darshacharya/KANDA/PUBLICATION_PLAN.md

# KANDA Paper Publication Plan

**Paper:** "KANDA: A Multimodal Embodied Robot Agent Driven by Large Language Models for Hardware-Conscious Command Generation"  
**Authors:** Sudarshan T S, Sushmitha N (RV College of Engineering, Bengaluru)  
**Date:** June 1, 2026

---

## Paper Summary

KANDA is a $77 multimodal embodied robot agent (ESP32 + Raspberry Pi 4 + camera) with voice, vision, text, and Telegram input. Uses Groq Llama 3.3 for text reasoning and NVIDIA NIM Llama 3.2 Vision for visual understanding. Features a deliberative-critic-reflex safety architecture based on Brooks' subsumption model. Key results: intent F1 = 0.94, visual search 80% success, all 8 injected faults terminate safely.

---

## Venue Options (Ranked by Budget)

### Tier 1: FREE ($0)

#### 1. Discover Robotics (Springer Nature) — TOP PICK
- **APC:** $0 / €0 / £0 (free until 31 Dec 2026)
- **Publisher:** Springer Nature
- **Indexing:** DOAJ; likely Scopus soon
- **Review:** Single-anonymous peer review
- **Type:** Journal (open access)
- **Turnaround:** ~29 weeks submission to publication
- **Link:** https://link.springer.com/journal/44430
- **Scope:** All fields of robotics — robot navigation, neurorobotics, bio-inspired learning, novel sensors
- **Why it fits:** LLM-driven embodied agent with hardware-aware action generation falls squarely in scope. Springer Nature imprint gives credibility. Newer journal (2024) so acceptance bar is more lenient.
- **Action:** Submit now. APC-free window closes 31 Dec 2026.

#### 2. arXiv Preprint (cs.RO)
- **Cost:** $0
- **Indexing:** Google Scholar, Semantic Scholar
- **Type:** Preprint (not peer-reviewed)
- **Turnaround:** 1-2 days
- **Why:** Citable DOI immediately, establish priority. Most venues allow dual arXiv + journal submission.

---

### Tier 2: VERY LOW COST (Under ₹5,000 / ~$60)

#### 3. AIRIM-2026 — AI, Robotics and Intelligent Manufacturing
- **Fee:** ₹4,000 + 18% GST (~₹4,720 / ~$56) for students with Scopus publication
- **Venue:** SRM University AP, Nov 5-7, 2026
- **Proceedings:** Springer "Lecture Notes in Networks and Systems" (Scopus-indexed)
- **Format:** Springer, up to 10 pages
- **Link:** https://www.srmap.edu.in/airim-2026/
- **Deadlines:** Paper submission revised Oct 2026; registration Aug-Oct 2026

#### 4. ICCMRAI-2026 — Computer, Mechatronics, Robotics & AI
- **Fee:** ₹4,000 (IEEE Student Member, early bird) / ₹5,000 (non-IEEE student)
- **Venue:** MMIT Pune, Jul 15-16, 2026
- **Proceedings:** IEEE Xplore (if presented)
- **Link:** https://mmit.edu.in/ieee-conference/
- **Note:** First edition — high acceptance likely. Check for late submission round.

#### 5. CIACON 2026 — IEEE Conference
- **Fee:** ₹5,000 (student, early bird before Jun 15)
- **Venue:** BC Roy Engineering College, India
- **Proceedings:** IEEE Xplore
- **Link:** https://ciacon.in/reg.html

---

### Tier 3: LOW COST (₹5,000–₹8,500 / ~$60–100)

#### 6. CSITSS 2026 — RVCE's Own Conference ⭐ HOME ADVANTAGE
- **Full Name:** International Conference on Computational Systems and Information Technology for Sustainable Solutions
- **Organizer:** RV College of Engineering, Bengaluru (home college)
- **Partner:** IEEE Bangalore Section
- **Dates:** Oct 30-31, 2026
- **Proceedings:** IEEE Xplore
- **Fee (IEEE student):** ₹5,310 (early bird, before Aug 30)
- **Fee (non-IEEE student):** ₹6,490 (early bird)
- **Link:** https://csitss.ieee-rvce.org/
- **Submission portal:** https://cmt3.research.microsoft.com/CSITSS2025
- **Key Dates:**
  - Submission opens: Apr 16, 2026
  - Last date to submit: **Jun 14, 2026**
  - Early bird registration deadline: Aug 30, 2026
  - Camera-ready + copyright: Sep 26, 2026
  - Conference: Oct 30-31, 2026
- **Best Track:** Track C — Advanced Robotics and Digital Technologies for Industrial Automation
- **Also fits:** Track A — Computing and Intelligent Systems
- **Relevant themes:** Soft Robotics, Generative & Agentic AI, Large Language Models and Generative AI, Cyber Physical System, AIoT
- **Why it fits:** Home advantage — guide Prof. Sushmitha N is from RVCE ISE dept which co-organizes. IEEE Xplore indexing. No travel cost. Higher acceptance rate for home institution. 6-page limit.
- **CSITSS trimmed version:** `kanda/overleaf/paper/kanda_csitss.tex` (435 lines, ~6 pages)

#### 7. IEEE ICRM 2026 — Robotics and Mechatronics
- **Fee:** ₹6,500 + GST (~₹7,670 / ~$91) for IEEE student author
- **Venue:** Amrita University, Kerala (virtual)
- **Proceedings:** IEEE Xplore
- **Link:** https://www.amrita.edu/events/icrm/

#### 8. COSMIC-2026 — Computing, Semiconductor, Mechatronics, Intelligent Systems
- **Fee:** TBD (~₹6,000-8,000 for students)
- **Venue:** Sahyadri College, Mangaluru, Nov 27-28, 2026
- **Proceedings:** IEEE Xplore + Scopus
- **Submission deadline:** Jul 10, 2026
- **Link:** https://cosmic.sahyadri.edu.in

---

### Tier 4: MODERATE COST (Journals with APC)

#### 9. HardwareX (Elsevier)
- **APC:** $500 (geo-pricing may reduce for India)
- **Indexing:** Scopus, DOAJ, ScienceDirect
- **Link:** https://www.sciencedirect.com/journal/hardwarex
- **Caveat:** Requires HardwareX template (hardware-focused). Need open hardware license. May need restructuring.

#### 10. MDPI Robotics
- **APC:** CHF 1,800 (~$2,000) — waivers available
- **Indexing:** Scopus, ESCI (Web of Science), dblp
- **Rank:** JCR Q2 (Robotics), CiteScore Q1
- **Turnaround:** ~24 days to first decision
- **Link:** https://www.mdpi.com/journal/robotics

#### 11. LITES — Leibniz Transactions on Embedded Systems
- **APC:** €100 (waivers for developing countries)
- **Indexing:** Open access
- **Link:** https://ojs.dagstuhl.de/index.php/lites/

#### 12. IEEE Access
- **APC:** $2,160 (20% discount for IEEE Society members)
- **Indexing:** Scopus, Web of Science
- **Link:** https://ieeeaccess.ieee.org/

---

## Recommended Strategy

1. **Immediate:** Submit to **arXiv (cs.RO)** — free, establishes priority, citable
2. **By Jun 14:** Submit trimmed 6-page version to **CSITSS 2026** (home conference, IEEE Xplore, ₹5,310)
3. **Parallel:** Submit full version to **Discover Robotics** (Springer, free APC until Dec 2026)
4. **Backup:** If CSITSS is rejected, target **AIRIM-2026** (Nov, Scopus Springer) or **COSMIC-2026** (Nov, IEEE Xplore)

The **Discover Robotics + arXiv** combo gives a Springer journal publication and immediate preprint for **zero cost**.

---

## CSITSS 2026 Trimming Summary

Created `kanda_csitss.tex` (435 lines) from original `kanda.tex` (570 lines).

### What was cut:
| Cut | Details |
|-----|---|
| Section 3 (Formal Problem Definition) | Folded Def 1 & 2 into "Three Tiers and Safety Definitions"; dropped Def 3-5 |
| Related Work | Compressed from 3 paragraphs to 1 |
| Section 7 (Discussion) | Removed; key insights moved to Conclusion |
| Listing 1 (body-context block) | Removed; described in prose |
| Wire Protocol subsection | Removed; single UART sentence in tier description |
| Figure 3 (state machine) | Removed; states described in text |
| Figures 1 & 2 | Shrunk from 6.2/5.5cm to 5.0cm |
| Evaluation prose | Trimmed verbose explanations |
| References | Cut from 20 to 16 |

### What's preserved:
- Full abstract with all quantitative results
- All 5 tables (voice, faults, ablation, timing, BOM)
- Algorithm 1 (episodic visual search)
- Validator code listing
- Robot photo and architecture figures
- All key contributions and ablation evidence

---

## Files

| File | Description |
|---|---|
| `kanda/overleaf/paper/kanda.tex` | Full paper (~9-10 pages, IEEE format) |
| `kanda/overleaf/paper/kanda_csitss.tex` | CSITSS trimmed version (~6 pages) |
| `kanda/overleaf/paper/kanda_text.txt` | Plain text version of full paper |
| `kanda/overleaf/paper/gouth.tex` | (Other paper file) |
