darshacharya/KANDA/overleaf/chapters/chapter2.tex

% ================================================================
%  Chapter 2 — Theory and Concepts
%  KANDA (Knowledge-driven Autonomous Navigation and Decision-making Agent)
% ================================================================
\chapter{THEORY AND CONCEPTS}
\label{ch:theory}

Building a robot that listens, sees, thinks, and moves requires pulling ideas from several fields at once. This chapter lays out those ideas, not as a textbook survey, but tied directly to decisions I had to make while constructing KANDA. Why does the language model need to know the robot's sensor readings? Why can I not just send raw text to the motors? Why does the ESP32 need its own safety logic when the Pi is already running a validator? Each section answers one of these questions by grounding it in published work and then connecting it to my specific implementation choices.

%-------------------------------------------------------------------
\section{Embodied Artificial Intelligence}
\label{sec:embodied}

A language model sitting on a server can write poetry about walking, but it has never tripped over a cable. \textbf{Embodied AI} closes that gap; it insists that intelligent behaviour only makes sense when perception and action happen through a real body interacting with a physical world. The distinction matters practically: an embodied system must deal with noise from cheap sensors, latency over wireless links, and the fact that motors do not care about elegant sentences.

These systems cost tens or hundreds of thousands of dollars. KANDA asks a simpler question: can the \textit{behaviours} that matter for a desk-sized indoor robot (obstacle avoidance, voice commands, object search) run on a \$77 platform with no training data at all? The answer turns out to be yes, but only if I respect the old principle from Brooks~\cite{brooks1986robust} that fast reactive layers must sit beneath slow deliberative ones. My firmware reflex traces its lineage directly to subsumption architecture, even though the deliberation layer above it uses a 70-billion parameter model hosted in the cloud.

These systems cost tens or hundreds of thousands of dollars. KANDA asks a simpler question: can the \textit{behaviours} that matter for a desk-sized indoor robot (obstacle avoidance, voice commands, object search) run on a \$77 platform with no training data at all? The answer turns out to be yes, but only if we respect the old principle from Brooks~\cite{brooks1986robust} that fast reactive layers must sit beneath slow deliberative ones. Our firmware reflex traces its lineage directly to subsumption architecture, even though the deliberation layer above it uses a 70-billion parameter model hosted in the cloud.

%-------------------------------------------------------------------
\subsection{Affordance Grounding}
\label{subsec:affordance}

Gibson coined the term \textit{affordance} to describe what an environment offers a particular agent; a chair affords sitting for a human but not for a fish. In robotics, the question becomes: given a language command like ``put the cup on the shelf,'' which physical actions can this robot actually perform?

SayCan~\cite{ahn2022saycan} tackled this by training affordance functions from 68,000 demonstrations. When a user issued a command, the system combined the language model's preference with a learned feasibility score to pick actions the robot could physically execute. PaLM-E~\cite{driess2023palme} took a different route, embedding sensor tokens directly into the language model so it could reason about feasibility internally. RT-2~\cite{brohan2023rt2} pushed further; it fine-tuned a vision-language model end-to-end so that the model output was itself a motor command, eliminating the separate affordance filter.

I could not afford 68,000 demonstrations, a 562B model, or end-to-end fine-tuning. Instead, KANDA encodes affordances directly in the prompt: seven legal actions, a speed range of 0--255, and live ultrasonic distances. The model cannot propose ``fly'' or ``speed 500'' because the prompt tells it those do not exist. This is crude compared to learned affordances, but it costs nothing to maintain and catches most hallucinated actions before validation even runs.

%-------------------------------------------------------------------
\section{Large Language Models for Robot Control}
\label{sec:llm_robot}

Transformers~\cite{vaswani2017attention} revolutionised natural language processing by replacing recurrence with self-attention, enabling parallel training on massive corpora. The resulting models (GPT-4, Llama, Gemini) generate fluent text, but fluency does not imply physical feasibility. A model might confidently suggest ``accelerate to 400'' when the motor driver caps at 255.

The gap between linguistic competence and physical grounding defines the core challenge. Vemprala et al.~\cite{vemprala2024chatgpt} articulated this in 2024: successful LLM-robot integration requires (a)~a clear description of the robot's capabilities in the prompt, (b)~low-temperature sampling to suppress creative but dangerous outputs, and (c)~a post-generation filter that catches anything the prompt did not prevent. KANDA implements all three, though I arrived at this design through trial and error before reading their systematic treatment.

%-------------------------------------------------------------------
\subsection{Prompting as Interface Specification}
\label{subsec:prompting}

Rather than training models on robot data, several groups discovered that careful prompting alone can produce usable control outputs. Huang et al.~\cite{huang2022zeroshot} first demonstrated that language models serve as effective zero-shot planners when carefully framed. Liang et al.~\cite{liang2023code} framed the prompt as a Python API specification and let the model write policy code. Singh et al.~\cite{singh2023progprompt} went further, declaring robot functions and world state in the prompt so the model could generate situated programs.

Chain-of-thought prompting~\cite{wei2022cot} showed that forcing the model to ``think step by step'' improves multi-step planning. Yao et al.\ combined this with action execution in ReAct~\cite{yao2023react}, where the model alternates between reasoning traces and concrete actions, observing results before deciding the next step. Our visual search algorithm borrows this structure: capture a frame, describe it, decide whether the target is visible, then pick the next movement.

KANDA's prompt is deliberately simpler than these systems. I do not generate code or multi-step reasoning chains at inference time. The prompt specifies seven verbs, a numeric speed field, and current sensor readings. The model returns a single JSON line. This keeps the firmware parser trivial and the validator unambiguous.

%-------------------------------------------------------------------
\subsection{Grounded Decoding and Post-Hoc Validation}
\label{subsec:grounded}

Huang et al.~\cite{huang2023grounded} proposed an elegant idea: during token generation, multiply the language model's probability distribution by a grounding signal (e.g., a feasibility score from a physics model) so that infeasible tokens get suppressed before they even appear in the output. This requires access to the model's logits, something cloud APIs generally do not expose.

KANDA takes the conceptually similar but architecturally distinct approach of post-hoc validation. I let the model generate freely, then run a total function $V$ that either accepts the output (if action $\in$ whitelist and speed $\in [0,255]$) or replaces it with a stop command. The validator never raises an exception, never passes garbage downstream, and adds negligible latency ($<$1\,ms). It is less elegant than logit-level intervention, but works with any API, any model, and any future provider swap.

%-------------------------------------------------------------------
\section{Sense-Reason-Act Architecture}
\label{sec:sra}

Most autonomous robots follow a loop: read sensors, compute a decision, execute it, repeat. KANDA splits this across two processors running at wildly different speeds, and that split drives much of the architecture.

The ESP32 reads three ultrasonic sensors every 100\,ms, fast enough to catch a hand waving in front of the robot. The Raspberry Pi calls Groq or NVIDIA NIM over the network, which takes 1.5--4 seconds depending on server load and prompt length. If I forced the ESP32 to wait for every cloud response, the robot would lurch forward blindly during those seconds. Instead, the firmware runs its own obstacle-avoidance rules whenever the Pi has not sent a command recently (timeout: 3 seconds). The Pi's commands override these rules when they arrive, but the firmware never stops watching the sensors.

This is not a novel idea; Brooks described it in 1986~\cite{brooks1986robust}. What is new is layering a cloud-hosted 70B-parameter model on top of a \$4 microcontroller and still preserving sub-100\,ms reflexes. The trick is accepting that the LLM is advisory, not authoritative. It suggests; the validator approves; the firmware obeys, or overrides if the wall is too close.

%-------------------------------------------------------------------
\section{Proximate Sensing with Ultrasonic Rangefinders}
\label{sec:ultrasonic}

HC-SR04 modules are cheap, widely available, and good enough for indoor obstacle detection within 2--400\,cm. The Dynamic Window Approach~\cite{fox1997dwa} provides a formal basis for velocity-space obstacle avoidance; our threshold-based design simplifies this to a binary stop decision at 15\,cm. The principle is straightforward: a 40\,kHz burst leaves the transmitter, bounces off a surface, and returns to the receiver. The module holds an echo pin high for the round-trip duration $\Delta t$, and distance follows from $d = \frac{1}{2} \cdot 343 \cdot \Delta t$ metres at room temperature.

In practice, three issues dominated our debugging time. First, the 15-degree beam width means small objects at oblique angles go undetected. Second, running three sensors simultaneously causes cross-talk where one sensor picks up another's echo. We solved this by triggering them sequentially within each loop iteration. Third, the HC-SR04 outputs 5V echo pulses, but ESP32 GPIO pins tolerate only 3.3V. Resistor dividers on each echo line handle the level shift; without them, the ESP32 reads noise or risks input damage.

%-------------------------------------------------------------------
\section{PWM Actuation and Motor Drive}
\label{sec:pwm}

DC motors spin faster with higher average voltage. Rather than regulating actual voltage, we switch full supply on and off rapidly (Pulse Width Modulation) so that the motor sees an effective average proportional to the duty cycle. The ESP32's LEDC peripheral~\cite{espressif2023esp32} generates PWM signals with 8-bit resolution (0--255) at 1\,kHz, which is high enough that the motors hum rather than click.

The TB6612FNG dual H-bridge sits between the ESP32 logic and the motors. Two direction pins per channel set forward or reverse; one PWM pin per channel sets speed. For differential steering, equal duty on both channels drives straight; unequal duty turns gently; reversing one channel spins in place. KANDA maps abstract LLM verbs (\textit{forward}, \textit{slight\_left}, \textit{right}) to specific combinations of direction bits and PWM values in firmware, so the language model never deals with pin-level hardware.

%-------------------------------------------------------------------
\section{Inter-Processor Communication over UART}
\label{sec:uart}

UART serial at 115,200 baud connects the Raspberry Pi and ESP32 with just two wires (TX and RX, plus ground). No clock line, no protocol negotiation; bytes flow at the agreed rate with start and stop framing. I chose newline-terminated JSON as the message format for a practical reason: it is human-readable in a serial monitor, which saved hours during early integration when half the bugs were bad baud rates or swapped TX/RX wires.

The Pi sends one JSON object per line: \textit{\{"action":"forward","speed":120\}}. The ESP32 replies with sensor telemetry in a fixed ASCII format: \textit{F:30.5 L:21.0 R:16.4 -> FORWARD}. Both sides use newline as the message delimiter. ArduinoJson parses the inbound line on the ESP32; Python's \textit{json.loads} handles it on the Pi. The simplicity of this protocol (no handshake, no sequence numbers, no retransmission) means occasional dropped bytes produce a parse failure that the validator catches and maps to stop. Reliability through simplicity.

%-------------------------------------------------------------------
\section{Safety Validation for LLM-Generated Actions}
\label{sec:safety_theory}

Language models hallucinate. They invent actions that do not exist, propose speeds that exceed hardware limits, wrap JSON in markdown fences, or occasionally return poetry instead of motor commands. KANDA assumes every LLM output is adversarial until proven otherwise.

The validator implements four checks in sequence: (1)~is the output a dictionary with the right keys? (2)~is the action one of seven known verbs? (3)~can the speed field be parsed as an integer? (4)~is that integer within $[0,255]$? Failure at any stage produces a safe stop command. Speed values outside the range but otherwise valid get clamped rather than rejected, so ``speed 300'' becomes ``speed 255'' rather than a full stop. This design treats the validator as a total function: it always terminates, always returns a legal command, and never throws~\cite{huang2023grounded,ahn2022saycan}.

The firmware adds a second, independent safety layer. Even if the Pi's validator somehow passes a forward command while an obstacle sits 10\,cm ahead, the ESP32's own loop checks the front sensor and overrides with a stop. Two independent checks, running on separate processors, make single-point failure of safety essentially impossible for the collision case.

%-------------------------------------------------------------------
\section{Multimodal Extension}
\label{sec:multimodal}

Phase~4 of KANDA adds a camera, microphone, and speaker, turning it from a text-controlled rover into a multimodal agent. The conceptual basis draws from several 2022--2023 systems.

Wake et al.~\cite{wake2023gptrobot} showed that ChatGPT can plan multi-step robot actions in diverse environments when given adequate scene descriptions. Wu et al.~\cite{wu2023tidybot} built a robot that learns personal preferences via language, deciding where specific objects belong in a household. Zeng et al.~\cite{zeng2023socratic} composed separately trained models (vision, language, audio) by passing natural-language summaries between them, requiring no joint training. Huang et al.~\cite{huang2022innermonologue} fed observation text back into the planner so the robot could notice when actions failed and try alternatives.

KANDA's search algorithm combines these ideas: the vision model describes each captured frame, the text model decides whether the target is visible and which direction to explore next, and episodic memory prevents the robot from revisiting scenes it has already checked. The entire loop stays within the same validation boundary that governs simple motion commands, so even during a 20-step search, every individual movement passes through the safety validator before reaching the wheels.

%-------------------------------------------------------------------
\section{Summary}
\label{sec:ch2summary}

The theoretical basis of KANDA spans classical robotics and frontier AI. From Brooks~\cite{brooks1986robust} we take the principle that reflexes must be fast and independent of slow planning. From the latest embodied LLM work~\cite{vemprala2024chatgpt,driess2023palme,brohan2023rt2} we borrow the idea of conditioning model outputs on hardware context and sensor state. From ReAct~\cite{yao2023react} and Inner Monologue~\cite{huang2022innermonologue} we take observation-driven replanning for multi-step tasks. The ultrasonic sensors, PWM motor control, UART protocol, and runtime validator are not theoretically novel (they are well-understood engineering) but combining them with cloud-hosted LLMs in a coherent, safe architecture on a sub-\$77 platform is the contribution this project demonstrates.
