darshacharya/KANDA/overleaf/chapters/chapter3.tex

% ================================================================
%  Chapter 3 — Software Requirement Specification
%  KANDA (Knowledge-driven Autonomous Navigation and Decision-making Agent)
% ================================================================
\chapter{SOFTWARE REQUIREMENT SPECIFICATION}
\label{ch:srs}

This chapter presents the Software Requirement Specification (SRS) for Knowledge-driven Autonomous Navigation and Decision-making Agent (KANDA). It documents the product perspective, functions, user classes, constraints, and both functional and non-functional requirements for the dual-layer system (ESP32 embodiment layer and Raspberry Pi intelligence layer). The SRS is the formal contract between system design and implementation. Design principles follow established robotics-LLM practice for grounding LLM outputs in robot capabilities~\cite{vemprala2024chatgpt,ahn2022saycan}.

%-------------------------------------------------------------------
\section{Overall Description}
\label{sec:overall}

%-------------------------------------------------------------------
\subsection{Product Perspective}
\label{subsec:perspective}

KANDA is a standalone embedded robotic system consisting of two cooperating software stacks:

\begin{itemize}[nosep]
  \item Embodiment firmware (ESP32): Arduino-compatible C++ firmware on an ESP32 DevKit. It performs ultrasonic sensing, motor PWM control via TB6612FNG, SSD1306 OLED display updates, and UART messaging with the companion computer.

  \item Intelligence layer (Raspberry Pi): Python modules in \textit{vision\_module/} that read telemetry from the serial port, compose a hardware-aware prompt, call Groq (for text reasoning and speech-to-text) or NVIDIA NIM (for visual scene understanding), validate the returned JSON command, and transmit it to the ESP32.

\end{itemize}

The system interfaces with the following external services and components:

\begin{itemize}[nosep]
  \item Groq API: Cloud-hosted Groq inference service running \textit{llama-3.3-70b-versatile}. Handles text reasoning (motion planning) and automatic speech recognition (ASR). Free tier: 30 requests/min effectively unlimited in practice. Accessed via OpenAI-compatible REST endpoint; requires \textit{GROQ\_API\_KEY} environment variable.

  \item NVIDIA NIM API: Cloud-hosted NVIDIA model service running \textit{meta/llama-3.2-11b-vision-instruct}. Handles visual scene understanding and object detection. Free tier: 40 requests/min. Accessed via OpenAI-compatible REST endpoint; requires \textit{NVIDIA\_API\_KEY} environment variable.

  \item Google TTS (gtts): Optional cloud text-to-speech service for natural-sounding speech output. Runs on-demand, no API key required, but needs internet. Fallback: offline \textit{espeak-ng} for robotic fallback voice.

  \item UART link: Serial connection between Raspberry Pi and ESP32 at 115,200 baud. The device path is set via \textit{KANDA\_SERIAL\_PORT} (for example \textit{/dev/ttyS0} or \textit{/dev/ttyUSB0}).

  \item Power subsystems: Battery, BMS, buck converter, and motor supply paths as documented in project hardware notes; software assumes stable power within component ratings.
\end{itemize}

KANDA is not a hosted web service in the deployed configuration; the Pi runs the AI layer as a local process (e.g.\ \textit{python3 main.py}). The architecture separates real-time control on the microcontroller from asynchronous LLM inference on the companion computer, consistent with layered embodied systems~\cite{brooks1986robust,driess2023palme}.

%-------------------------------------------------------------------
\subsection{LLM Model Selection and System Alignment}
\label{subsec:alignment}

API services. Two complementary cloud services handle different workloads. Groq manages text and reasoning tasks plus automatic speech recognition, running Llama 3.3 70B. NVIDIA NIM handles visual understanding, running Llama 3.2 11B Vision. Both receive structured prompts with sensor context and return task-specific outputs. The dispatch logic sends reasoning requests to Groq and visual questions to NVIDIA, rather than routing all problems to a single model.

Why two services? Earlier versions used Gemini 2.5 Flash as a single LLM. Specialization proved more effective. Dedicated text models are faster for reasoning. Dedicated vision models handle visual questions better. When one service reaches its rate limit, the robot switches to the other and continues working instead of blocking.

Keeping the model honest (three layers of grounding). Safety depends on multiple independent checks. Each layer addresses different failure modes:

\begin{enumerate}[label=\arabic*., nosep]
  \item Specification alignment (prompt): The hardware-description prompt defines the action grammar, speed bounds, sensor semantics, and explicit safety rules. This makes the prompt match what the platform can actually do~\cite{ahn2022saycan,vemprala2024chatgpt}.
  \item Decoding alignment (generation): Low temperature sampling and JSON-only output reduce variance and make parsing simple on the microcontroller~\cite{}.
  \item Runtime alignment (validation): Every command passes through the validator before actuation. The validator enforces a finite action set and clamps numeric values~\cite{huang2023grounded}.
\end{enumerate}

Each layer catches different problems. Sensor data informs the prompt, the model proposes an action, and the validator stops anything unsafe before it reaches the motors.

%-------------------------------------------------------------------
\subsection{Product Functions}
\label{subsec:functions}

The primary functions of KANDA are:

Proximity sensing: Sample three HC-SR04 ultrasonic sensors (front, left, right) each control cycle and compute distances in centimetres.

Telemetry transmission: Format sensor readings as a single ASCII telemetry line and transmit from ESP32 to Raspberry Pi over UART for use in LLM context construction.

Prompt construction: Build a hardware-description prompt including valid motion primitives, speed bounds, safety rules, and current sensor readings~\cite{ahn2022saycan}.

LLM inference: For text-based tasks (motion planning), send the prompt to Groq Llama 3.3 70B to obtain a JSON array of motor commands. For visual tasks (object detection, scene questions), send the image and prompt to NVIDIA NIM Llama 3.2 11B Vision to get yes/no or descriptive answers. Both use low temperature (greedy decoding) and structured JSON output.

Command validation: Verify action membership in the configured whitelist, coerce speed to integer, clamp to $[0,255]$, and substitute a safe stop command on failure~\cite{huang2023grounded}.

Command transmission: Serialize the validated command as one JSON line over UART to the ESP32.

Motor actuation: Parse JSON on the ESP32 and drive TB6612FNG inputs (direction + PWM) to realise forward, backward, turns, slight corrections, or stop.

Status display: The SSD1306 OLED (128×64) shows the robot's state through an animated face. Humans instinctively look at the robot's face to understand what it's doing. Animated states make this obvious: IDLE shows a listening face, LISTENING shows a recording waveform, THINKING shows a thinking emoji, ACTING shows movement, SEARCHING shows a search pattern, SPEAKING shows a speech bubble, REPORTING shows completion. This simple feature reduced debugging time significantly, since the state was visible without reading logs.

Dual-mode operation: The ESP32 has two operating modes. When valid JSON arrives from the Pi, it runs in AI\_MODE and executes cloud-based decisions. If the Pi goes silent for 3 seconds (timeout: \textit{AI\_TIMEOUT\_MS=3000}), the firmware switches to AUTO\_MODE. In AUTO\_MODE, the ESP32 runs local obstacle avoidance using the ultrasonic sensors. This fallback means if the Pi crashes or loses network, the robot keeps avoiding obstacles instead of freezing or crashing.

Safe shutdown: On AI layer exit or error, send stop commands where applicable to leave the robot in a safe state.

%-------------------------------------------------------------------
\subsection{User Classes and Characteristics}
\label{subsec:users}

\textbf{Table~\ref{tab:users}} identifies four user classes that interact with the system at different levels of technical engagement.

\begin{table}[htbp!]
\centering
\caption[User classes and characteristics]{\textbf{User classes and characteristics}}
\label{tab:users}
\begin{tabularx}{\textwidth}{|l|l|X|}
\hline
\textbf{User Class} & \textbf{Technical Level} & \textbf{Description} \\
\hline
Robot Operator      & Basic          & Powers the robot, monitors OLED and behaviour, ensures clear operational space \\
\hline
Developer / Student & Intermediate   & Edits firmware or Python, configures serial port and API keys, flashes ESP32 \\
\hline
Researcher          & Intermediate   & Experiments with prompts, timing, and validation policies for embodied LLM studies \\
\hline
Lab Maintainer      & Advanced       & Manages hardware calibration, wiring, supply rails, and sensor mounting \\
\hline
\end{tabularx}
\end{table}

%-------------------------------------------------------------------
\subsection{Constraints}
\label{subsec:constraints}

\begin{description}[style=nextline]
  \item[Environment] Indoor, flat-floor operation assumed for specification and testing; outdoor use is outside the baseline SRS.

  \item[Language] LLM prompts and documentation are English; future speech modalities are out of scope for this SRS revision.

  \item[Network] Groq and NVIDIA NIM inference require outbound HTTPS. The robot maintains obstacle avoidance without cloud services by switching to AUTO\_MODE on the ESP32.

  \item[Credentials] API keys must be supplied via environment variables. Source repositories contain no hard-coded secrets.

  \item[Electrical] HC-SR04 ECHO outputs are 5V; ESP32 GPIO inputs require compliant level shifting (e.g.\ resistor dividers) as implemented in hardware.

  \item[Real-Time Bound] LLM latency varies and is not deterministic. The system does not assume sub-second planning. Instead, firmware timeouts and validation layers maintain safe motion limits~\cite{huang2023grounded}.
\end{description}

%-------------------------------------------------------------------
\section{Specific Requirements}
\label{sec:specific_req}

%-------------------------------------------------------------------
\subsection{Functional Requirements}
\label{subsec:func_req}

\textbf{Table~\ref{tab:func_req}} lists the fifteen functional requirements governing both layers. Each requirement is assigned a priority level (High or Medium) reflecting its importance to safe operation. High-priority items cover the core sense-reason-validate-act loop; medium-priority items address observability and configurability features that improve usability but are not safety-critical.

\begin{longtable}{|l|p{11cm}|c|}
\caption[Functional requirements]{\textbf{Functional requirements}}
\label{tab:func_req} \\
\hline
\textbf{ID} & \textbf{Requirement} & \textbf{Priority} \\
\hline
\endfirsthead
\caption[]{\textbf{Functional requirements (continued)}} \\
\hline
\textbf{ID} & \textbf{Requirement} & \textbf{Priority} \\
\hline
\endhead
\hline
\multicolumn{3}{r@{}}{\textit{Continued on next page}} \\
\hline
\endfoot
\hline
\endlastfoot
FR-01 & The embodiment layer shall sample three ultrasonic rangefinders and compute distances (cm) each control cycle & High \\
\hline
FR-02 & The embodiment layer shall transmit structured telemetry from ESP32 to Raspberry Pi over UART at 115,200 baud & High \\
\hline
FR-03 & The intelligence layer shall parse inbound telemetry into numeric front/left/right distances for prompt construction & High \\
\hline
FR-04 & The intelligence layer shall assemble a hardware-description prompt listing legal actions, speed bounds, safety rules, and live sensor readings & High \\
\hline
FR-05 & The intelligence layer shall invoke Groq (text) or NVIDIA NIM (vision) as configured and obtain a response parseable as JSON with \textit{action} and \textit{speed} (or task-specific fields for multimodal flows) & High \\
\hline
FR-06 & The intelligence layer shall validate each command's \textit{action} against \textit{VALID\_ACTIONS}, coerce \textit{speed} to integer, and clamp to $[0,255]$ before transmission & High \\
\hline
FR-07 & On validation failure or malformed output, the intelligence layer shall substitute a safe stop (e.g.\ \textit{\{``action'':``stop'',``speed'':0\}}) & High \\
\hline
FR-08 & The intelligence layer shall transmit one JSON command line per cycle to the ESP32 over the open serial port & High \\
\hline
FR-09 & The embodiment layer shall parse inbound JSON lines and map \textit{action} to motor primitives (forward, backward, pivot turns, slight corrections, stop) & High \\
\hline
FR-10 & The embodiment layer shall drive PWM and direction pins of the TB6612FNG per the commanded action and speed & High \\
\hline
FR-11 & The embodiment layer shall update the SSD1306 OLED with mode and status information visible to the operator & Medium \\
\hline
FR-12 & The embodiment layer shall enter AI\_MODE when valid JSON is received and revert to AUTO\_MODE after UART silence exceeding the configured timeout & High \\
\hline
FR-13 & In AUTO\_MODE, the embodiment layer shall execute rule-based obstacle avoidance using distance thresholds without cloud dependency & High \\
\hline
FR-14 & The intelligence layer shall support configurable loop interval and LLM timeout via central configuration & Medium \\
\hline
FR-15 & The intelligence layer shall log errors and command safe stop behaviour when telemetry is missing, serial I/O fails, or the LLM call raises an exception & High \\
\end{longtable}

%-------------------------------------------------------------------
\subsection{Performance Requirements}
\label{subsec:perf_req}

\textbf{Table~\ref{tab:perf_req}} specifies measurable performance targets.

\begin{table}[H]
\centering
\caption[Performance requirements]{\textbf{Performance requirements}}
\label{tab:perf_req}
\begin{tabularx}{\textwidth}{|>{\raggedright\arraybackslash}p{2.2cm}|>{\raggedright\arraybackslash}X|>{\raggedright\arraybackslash}X|}
\hline
\textbf{ID} & \textbf{Metric} & \textbf{Target / threshold} \\
\hline
PR-01 & Ultrasonic ranging (single sensor, one ping) & Complete within sensor timing budget ($<$40\,ms typical) \\
\hline
PR-02 & UART throughput & 115,200 baud sustained \\
\hline
PR-03 & AI layer control loop period & Default 2.0\,s between cycles (\textit{LOOP\_INTERVAL\_SEC}) \\
\hline
PR-04 & LLM inference budget & Complete within 8.0\,s before fallback (\textit{LLM\_TIMEOUT\_SEC}) \\
\hline
PR-05 & Firmware AI\_MODE watchdog & Revert to AUTO\_MODE after 5000\,ms without valid JSON (\textit{AI\_TIMEOUT\_MS}) \\
\hline
PR-06 & OLED refresh & Readable update on each major state change \\
\hline
PR-07 & Serial port stabilisation (cold start) & Allow $\approx$2\,s after opening the port on the Pi \\
\hline
\end{tabularx}
\end{table}

%-------------------------------------------------------------------
\subsection{Software Requirements}
\label{subsec:sw_req}

\textbf{Table~\ref{tab:sw_req}} lists the software dependencies for both layers.

\begin{table}[H]
\centering
\caption[Software requirements]{\textbf{Software requirements}}
\label{tab:sw_req}
\begin{tabularx}{\textwidth}{|>{\raggedright\arraybackslash}p{3.2cm}|>{\raggedright\arraybackslash}X|}
\hline
\textbf{Component} & \textbf{Requirement} \\
\hline
Embodiment toolchain & Arduino IDE or PlatformIO; ESP32 Arduino core v3+ \\
\hline
Firmware libraries     & Wire; Adafruit SSD1306 / GFX; ArduinoJson \\
\hline
Intelligence OS        & Raspberry Pi OS or compatible Linux on Raspberry Pi \\
\hline
Python                 & Python 3.10+ recommended \\
\hline
LLM / VLM clients      & HTTPS to Groq (\textit{llama-3.3-70b-versatile}) and NVIDIA NIM (\textit{meta/llama-3.2-11b-vision-instruct}); keys \textit{GROQ\_API\_KEY}, \textit{NVIDIA\_API\_KEY} \\
\hline
Serial I/O             & Package \textit{pyserial} \\
\hline
Configuration          & Env.\ vars above plus \textit{KANDA\_SERIAL\_PORT} \\
\hline
\end{tabularx}
\end{table}

%-------------------------------------------------------------------
\subsection{Hardware Requirements}
\label{subsec:hw_req}

\textbf{Table~\ref{tab:hw_req}} enumerates the minimum hardware and \textbf{Figure~\ref{fig:hw_block}} shows the interconnection topology.

\begin{table}[H]
\centering
\caption[Hardware requirements]{\textbf{Hardware requirements}}
\label{tab:hw_req}
\begin{tabularx}{\textwidth}{|>{\raggedright\arraybackslash}p{3.2cm}|>{\raggedright\arraybackslash}X|>{\raggedright\arraybackslash}X|}
\hline
\textbf{Component} & \textbf{Minimum} & \textbf{Notes} \\
\hline
ESP32 DevKit & 38-pin module & Wi-Fi-capable; GPIO set per pin map \\
\hline
Motor driver & TB6612FNG or equivalent dual H-bridge & Motor supply separate from logic rails \\
\hline
Ultrasonic sensors & 3$\times$ HC-SR04 & Dividers on ECHO lines to 3.3\,V logic \\
\hline
Display & SSD1306 128$\times$64 I\textsuperscript{2}C & Typical address \textit{0x3C} \\
\hline
Raspberry Pi & Pi 3B+ or newer & Hosts intelligence layer; network needed for Groq and NVIDIA NIM \\
\hline
Power & LiPo, BMS, buck converter & Motors not powered from the logic regulator \\
\hline
USB serial link & Optional USB--UART adapter & Use if not wiring Pi UART GPIO to ESP32 \\
\hline
\end{tabularx}
\end{table}

\textit{Note: GPU acceleration is not required on the Pi; inference uses cloud APIs. On-device LLM inference is out of scope.}

\begin{figure}[H]
\centering
\begin{tikzpicture}[
  comp/.style={draw, thick, rounded corners=3pt, minimum height=0.8cm,
               minimum width=2.4cm, align=center, font=\footnotesize},
  bus/.style={draw, thick, -{Stealth[length=2mm]}},
  dbus/.style={draw, thick, {Stealth[length=2mm]}-{Stealth[length=2mm]}},
  node distance=0.6cm and 1.0cm
]
% Cloud
\node[comp, fill=gray!10, dashed] (cloud) {Groq + NVIDIA NIM\\(Cloud)};
% Pi
\node[comp, fill=blue!10, below=1.2cm of cloud] (pi) {Raspberry Pi 4\\Intelligence Layer};
\node[comp, fill=blue!5, left=0.6cm of pi, minimum width=1.5cm] (cam) {Pi Camera\\v2.1};
\node[comp, fill=blue!5, right=0.6cm of pi, minimum width=1.5cm] (mic) {USB Mic\\+ Speaker};
% ESP32
\node[comp, fill=orange!12, below=1.2cm of pi] (esp) {ESP32 DevKit\\Embodiment Layer};
% Peripherals
\node[comp, fill=yellow!10, below left=0.8cm and 0.8cm of esp, minimum width=1.8cm] (motor) {TB6612FNG\\Motors};
\node[comp, fill=yellow!10, below=0.8cm of esp, minimum width=1.8cm] (sensor) {HC-SR04\\$\times$3};
\node[comp, fill=yellow!10, below right=0.8cm and 0.8cm of esp, minimum width=1.8cm] (oled) {SSD1306\\OLED};
% Power
\node[comp, fill=red!8, right=0.6cm of esp, minimum width=1.5cm] (pwr) {LiPo+BMS\\Buck 5V};
% Connections
\draw[dbus] (pi) -- node[right, font=\tiny]{HTTPS} (cloud);
\draw[dbus] (pi) -- node[right, font=\tiny]{UART 115200} (esp);
\draw[bus] (cam) -- (pi);
\draw[bus] (mic) -- (pi);
\draw[bus] (esp) -- (motor);
\draw[dbus] (esp) -- (sensor);
\draw[bus] (esp) -- (oled);
\draw[bus] (pwr) -- (esp);
\end{tikzpicture}
\caption[Hardware interconnection block diagram: cloud, edge, and device tiers]{\textbf{Hardware interconnection block diagram: cloud, edge, and device tiers.}}
\label{fig:hw_block}
\end{figure}

%-------------------------------------------------------------------
\subsection{Design Constraints}
\label{subsec:design_constraints}

\begin{description}[style=nextline]
  \item[Structured Commands Only] The intelligence layer shall issue motor intents exclusively as single-line JSON objects with \textit{action} and \textit{speed}. Free-form natural language shall not be sent directly to motor routines~\cite{vemprala2024chatgpt}.

  \item[Validation Before Motion] No LLM output shall reach GPIO/PWM without passing through the validator aligned with affordance-grounding practice~\cite{ahn2022saycan,huang2023grounded}.

  \item[Bounded Action Space] The legal action set shall remain finite and enumerated in both firmware expectations and Python configuration to prevent undefined behaviours.

  \item[Graceful Degradation] Loss of cloud connectivity or Pi process failure shall not imply undefined motion: firmware falls back to AUTO\_MODE and avoidance thresholds.

  \item[Observability] Serial logging on the Pi shall record cycles, errors, and safe-stop events sufficient for debugging demonstration and safety review.

  \item[Configurability Without Reflash (Pi)] Serial baud, model name, loop interval, and timeouts shall be adjustable via configuration or environment where feasible without rebuilding firmware.
\end{description}

%-------------------------------------------------------------------
\section{Summary}
\label{sec:ch3summary}

This chapter presented the Software Requirement Specification for KANDA. The product perspective separated the ESP32 embodiment layer from the Raspberry Pi intelligence layer and identified external dependencies (Groq and NVIDIA NIM APIs, UART, power). Section~\ref{subsec:alignment} formalised the dual-service model selection and a three-layer \textit{alignment} strategy: specification (prompt), decoding (temperature and JSON contract), and runtime validation before actuation. Ten product functions covered sensing, telemetry, prompting, inference, validation, actuation, display, dual-mode operation, and shutdown behaviour. Four user classes were defined from operator to maintainer. Constraints addressed environment, language, network, credentials, electrical interfacing, and stochastic LLM latency. Fifteen functional requirements, seven performance targets aligned with implementation constants, software and hardware dependency tables, and six design constraints formalised the contract for subsequent design chapters. Grounding and validation requirements~\cite{ahn2022saycan,huang2023grounded,vemprala2024chatgpt} are central to DC-01 and DC-02 and underpin the high-level architecture in Chapter~4.
