darshacharya/KANDA/overleaf/chapters/chapter4.tex

% ================================================================
%  Chapter 4 — High Level Design (KANDA)
%  Knowledge-driven Autonomous Navigation and Decision-making Agent
% ================================================================
\chapter{HIGH LEVEL DESIGN}
\label{ch:hld}

This chapter explains how I designed KANDA to solve the problems from Chapter 1 while meeting the requirements from Chapter 3. Rather than start with formal specifications, I describe the real design choices and their rationale. The ESP32 handles time-critical sensing and motor control. The Raspberry Pi handles slower language-model tasks. Safety comes from three independent validation layers that check every command before motors run. I learned early that language models produce garbage sometimes, and you don't want that reaching the motors.

%-------------------------------------------------------------------
\section{Design Considerations}
\label{sec:design}

%-------------------------------------------------------------------
\subsection{General Considerations}
\label{subsec:general}

The following considerations shaped the high-level design of KANDA:

Safety before motion: Language models sometimes produce invalid output. Malformed JSON, made-up action names, speed values outside the valid range. Raw LLM output cannot go directly to motors. Every command must pass strict checks. Is it valid JSON? Is the action in the whitelist? Is the speed between 0 and 255? If any check fails, the robot stops.

Layered architecture: All components organize into independent layers. The bottom layer handles raw sensing and motor control (ESP32). The middle layer manages message passing and validation (Raspberry Pi). The top layer does reasoning (Groq, NVIDIA NIM). Each layer has a narrow interface: telemetry lines and JSON lines only. This makes debugging easier because you know where to look when something breaks.

Timing mismatch: The ESP32 samples sensors every 100 milliseconds. Cloud API calls take 1.5 to 4 seconds. Waiting for every cloud response would freeze the robot. Instead, the ESP32 runs local obstacle-avoidance logic independently. When the Pi goes silent (network lag or API timeout), the ESP32 avoids obstacles on its own. Not intelligent, but safe.

Structured commands: Instead of sending natural language to the firmware ("move forward carefully"), I send only JSON with two fields: \textit{action} (must be one of seven words) and \textit{speed} (must be 0--255). This way the firmware parser is dead simple and cannot be confused.

Observability: The OLED screen shows the robot's current state (listening, thinking, acting, searching). You can watch the robot without opening a terminal. The Pi logs all events as well. This combination saved countless debugging hours.

Graceful degradation: Loss of Wi-Fi, API downtime, or Pi crashes don't freeze the robot. The firmware detects silence from the Pi and switches to obstacle-avoidance mode. Not smart, but the robot stays alive.

%-------------------------------------------------------------------
\subsection{Development Methods}
\label{subsec:dev_methods}

KANDA was built incrementally: each phase works on its own before I added the next layer.

\begin{description}[nosep]
  \item[Foundations:] Read papers, sketch requirements, design the basic architecture (Chapters 1-3). Nothing physical yet.
  
  \item[Embodiment layer:] Get the ESP32 working: read ultrasonic sensors, drive motors via the H-bridge, display status on the OLED. By itself, it could avoid obstacles. No Pi, no AI, just firmware. This baseline took longer than expected because voltage dividers and sensor crosstalk are tricky.
  
  \item[Intelligence layer:] Add the Raspberry Pi running Python, connect to Groq (text) and NVIDIA NIM (vision), build prompts, send JSON commands to the ESP32. The firmware gets an AI\_MODE for good commands and an AUTO\_MODE fallback when the Pi is silent. The 3-second timeout proved critical for safety.
  
  \item[Multimodal agent:] Add camera, microphone, wake-word detection, text-to-speech, Telegram bot, and a 7-state event machine. The OLED gets animated faces. The Pi understands images and voice. This phase focuses on integration. ReAct search with semantic memory prevents revisiting areas.
\end{description}

%-------------------------------------------------------------------
\section{Architectural Strategies}
\label{sec:arch_strat}

%-------------------------------------------------------------------
\subsection{Programming Language and Runtime Selection}
\label{subsec:lang}

Arduino-compatible C++ targets the ESP32 firmware: direct register and peripheral access, deterministic sampling intervals, mature motor-control patterns, and small binary size~\cite{espressif2023esp32}.

Python~3 targets the Raspberry Pi intelligence layer: \textit{pyserial} for UART communication, and fast iteration on reasoning. The system uses two cloud APIs: Groq Llama 3.3 70B for text reasoning and motion planning, and NVIDIA NIM Llama 3.2 11B Vision for visual scene understanding. I use \textit{openWakeWord} (offline, no API) for wake detection, Google Text-to-Speech (free, no key) for voice output, and \textit{picamera2} for image capture.

JSON line protocol over UART at 115,200 baud provides human-readable debugging, explicit message boundaries (newline-terminated lines), and straightforward parsing on both ends without custom framing beyond newline delimiters.

%-------------------------------------------------------------------
\subsection{Future Extensions}
\label{subsec:future}

Planned extensions beyond the baseline include on-device telemetry buffering, SLAM integration, depth sensors, and local-model experiments (Gemma 2B). All future work maintains the validation layer before actuation~\cite{huang2023grounded}.

%-------------------------------------------------------------------
\subsection{Safety Validation Pipeline}
\label{subsec:safety_pipeline}

A central design principle is defence-in-depth: no single layer alone protects the physical plant. \textbf{Figure~\ref{fig:safety_pipeline}} illustrates the three-layer safety pipeline that intercepts every command between the LLM and the motors.

\begin{figure}[H]
\centering
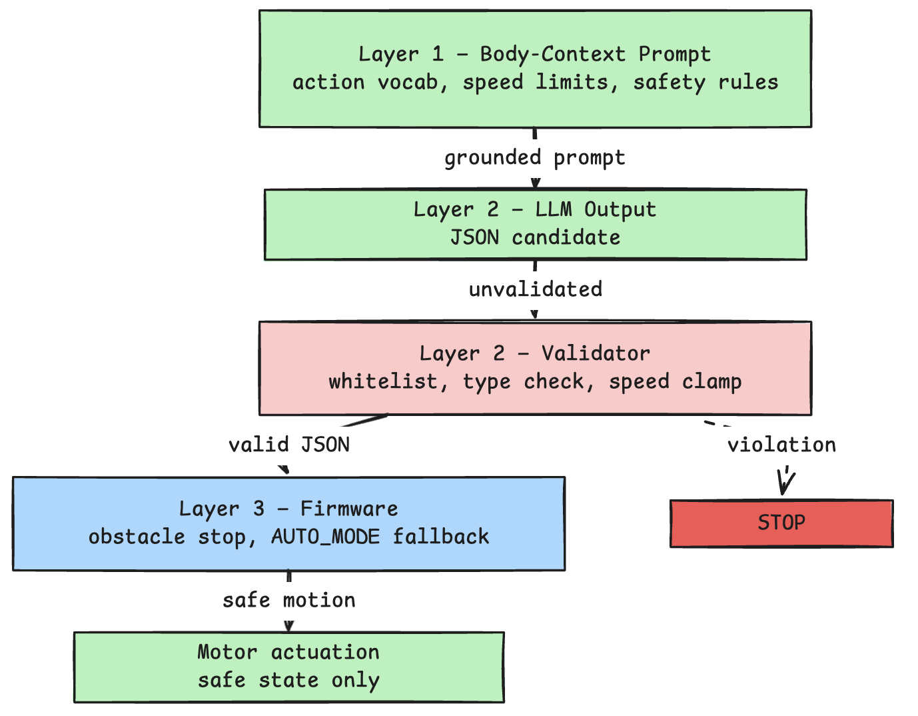
[picture p6: overleaf/images/4_1.png]

\caption[Three-layer safety validation pipeline]{\textbf{Three-layer safety validation pipeline.}}
\label{fig:safety_pipeline}
\end{figure}

%-------------------------------------------------------------------
\section{System Architecture}
\label{sec:sysarch}

KANDA is structured as a three-tier logical architecture: intelligence on the Raspberry Pi, a duplex UART link, and embodiment on the ESP32 interfacing to sensors, drivers, and display. \textbf{Figure~\ref{fig:sysarch}} summarises the layering.

\begin{figure}[H]
\centering
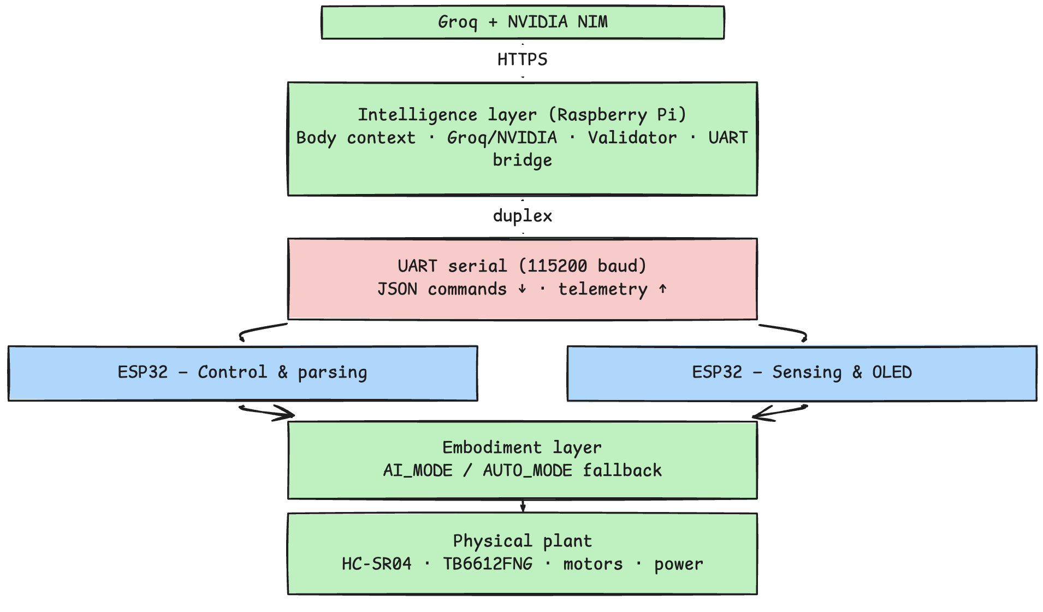
[picture p7: overleaf/images/4_2.png]

\caption[High-level layered architecture of KANDA]{\textbf{High-level layered architecture of KANDA.}}
\label{fig:sysarch}
\end{figure}

\textbf{Fig.~\ref{fig:sysarch}} shows how responsibilities are split. The \textit{intelligence layer} performs hardware-aware prompting, calls Groq (text) and NVIDIA NIM (vision), validates JSON commands, and transmits safe motor intents over UART. The \textit{UART link} carries newline-terminated ASCII lines in both directions. The \textit{embodiment layer} parses commands, drives motors, samples ultrasonic sensors, refreshes the OLED, and enforces mode logic including fallback to AUTO\_MODE. The \textit{physical plant} captures sensors, actuators, and power paths documented in hardware chapters.

%-------------------------------------------------------------------
\section{Data Flow Diagrams}
\label{sec:dfd}

%-------------------------------------------------------------------
\subsection{Data Flow Diagram Level~0, Overall System}
\label{subsec:dfd0}

The Level~0 DFD places KANDA at the centre of three external entities: the human operator who starts, stops, and monitors the system; the cloud inference services (Groq for text reasoning and NVIDIA NIM for visual understanding) that provide cognitive capability; and the physical deployment environment whose obstacle layout changes in response to the robot's own motion.

\begin{figure}[H]
\centering
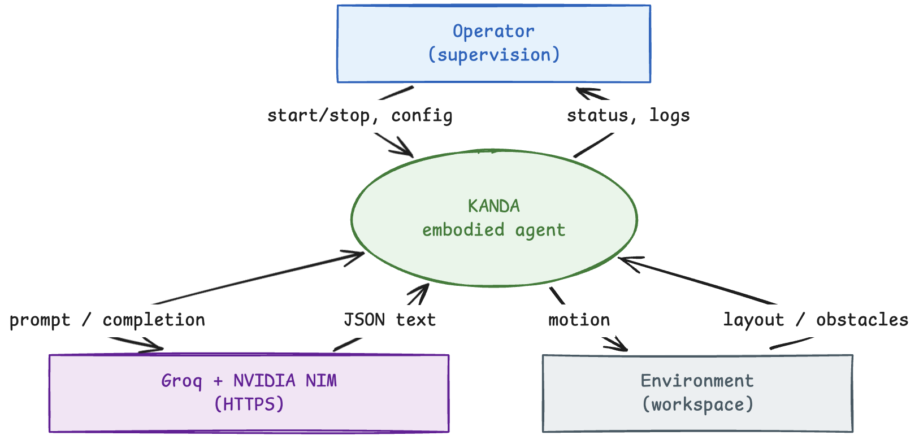
[picture p8: overleaf/images/4_3.png]

\caption[Data flow diagram Level 0]{\textbf{Data flow diagram Level~0.}}
\label{fig:dfd0}
\end{figure}

\textbf{Fig.~\ref{fig:dfd0}} abstracts KANDA as a single process. The \textit{operator} starts or stops runs and may adjust configuration while receiving status and logs. The system exchanges HTTPS messages with \textit{Groq and NVIDIA NIM}: prompts ascend and structured completions descend. Interaction with the \textit{environment} captures that motion changes the scene layout, including obstacle distances reflected indirectly through onboard sensing inside the system boundary.

%-------------------------------------------------------------------
\subsection{Data Flow Diagram Level~1, Embodiment and Intelligence}
\label{subsec:dfd1}

The Level~1 DFD decomposes KANDA into two cooperating sub-systems linked by the UART channel.

\begin{figure}[H]
\centering
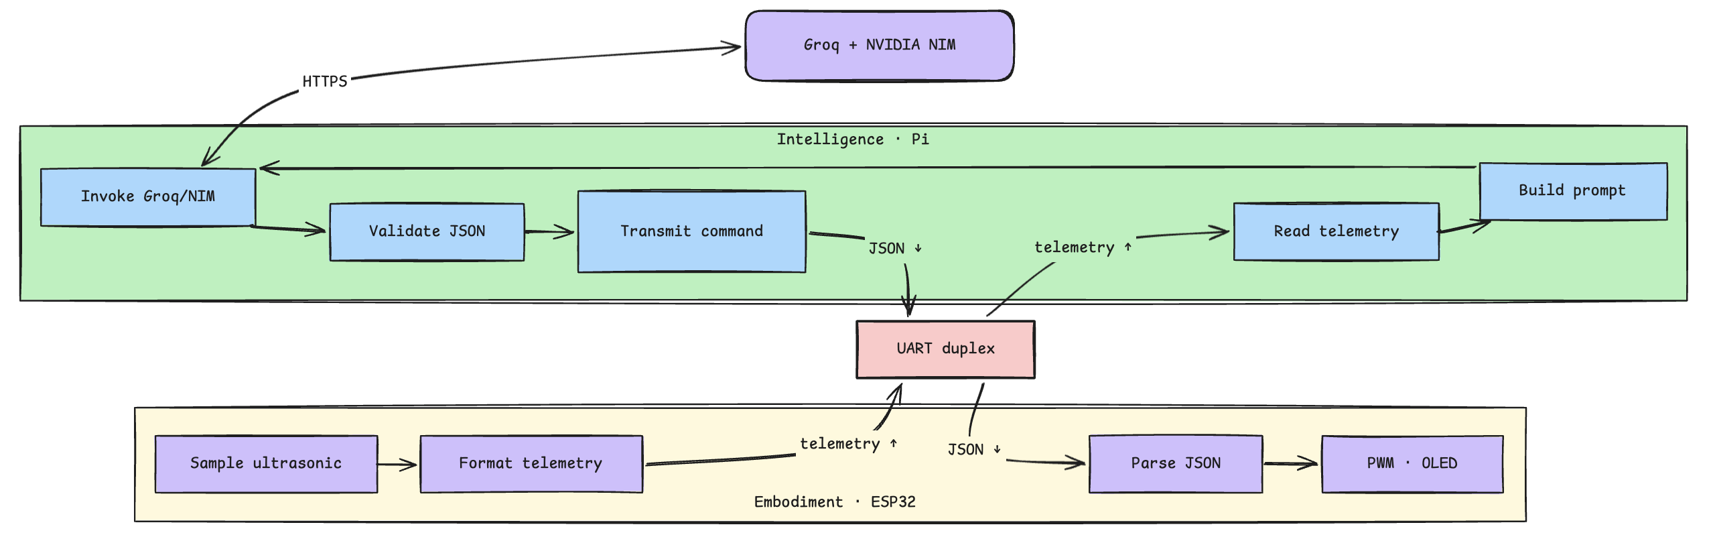
[picture p9: overleaf/images/4_4.png]

\caption[Data flow diagram Level 1]{\textbf{Data flow diagram Level~1.}}
\label{fig:dfd1}
\end{figure}

\textbf{Fig.~\ref{fig:dfd1}} separates real-time embodiment (left) from asynchronous intelligence (right). Telemetry formatted on the ESP32 flows upward to the Raspberry Pi; validated JSON commands flow downward after prompt construction, cloud inference, and validation. HTTPS exchanges with Groq and NVIDIA NIM attach to the intelligence column (expanded at Level~2).

%-------------------------------------------------------------------
\subsection{Data Flow Diagram Level~2, Intelligence Pipeline}
\label{subsec:dfd2_intel}

\begin{figure}[H]
\centering
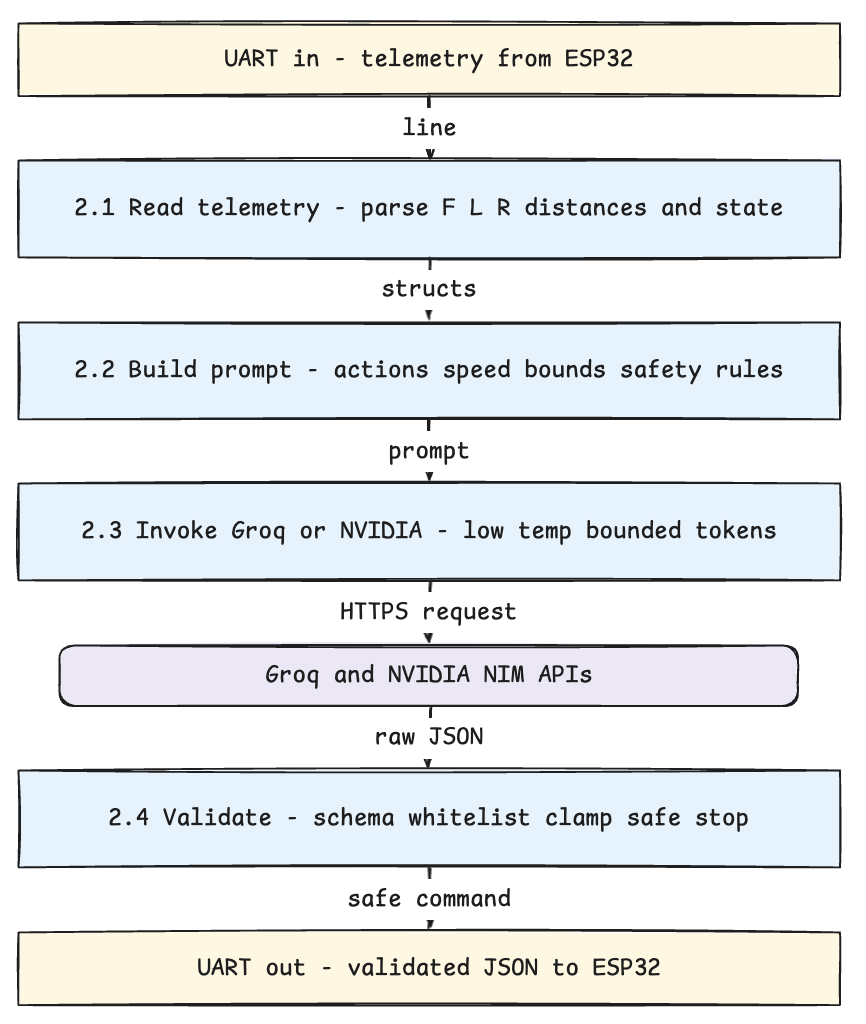
[picture p10: overleaf/images/4_5.png]

\caption[Data flow diagram Level 2, intelligence pipeline]{\textbf{Data flow diagram Level~2, intelligence pipeline.}}
\label{fig:dfd2a}
\end{figure}

\textbf{Fig.~\ref{fig:dfd2a}} details the Pi-side pipeline implemented by \textit{vision\_module/main.py} and companion modules: telemetry ingestion, hardware-aware prompt construction, Groq/NVIDIA invocation, validation, and transmission of a single safe JSON line per cycle.

%-------------------------------------------------------------------
\subsection{Data Flow Diagram Level~2, Embodiment Pipeline}
\label{subsec:dfd2_emb}

\begin{figure}[H]
\centering
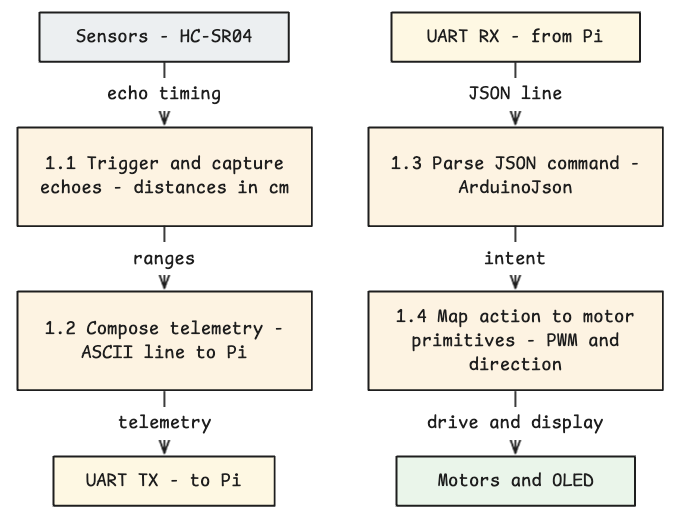
[picture p11: overleaf/images/4_6.png]

\caption[Data flow diagram Level 2, embodiment pipeline]{\textbf{Data flow diagram Level~2, embodiment pipeline.}}
\label{fig:dfd2b}
\end{figure}

\textbf{Fig.~\ref{fig:dfd2b}} expands embodiment-side processing: ranging, telemetry uplink, inbound JSON parsing, mapping discrete actions to TB6612FNG outputs, and operator-visible OLED updates. Watchdog and AUTO\_MODE transitions are policy logic around these flows.

%-------------------------------------------------------------------
\section{Summary}
\label{sec:ch4summary}

This chapter presented the high-level design of KANDA. Design considerations emphasised validation before actuation~\cite{huang2023grounded}, affordance-grounded command formats~\cite{ahn2022saycan}, layered embodied structure~\cite{brooks1986robust}, and resilience to stochastic cloud latency~\cite{vemprala2024chatgpt}. Development followed phased delivery from embodiment to intelligence, with a documented path toward multimodal extensions~\cite{zeng2023socratic,wu2023tidybot}.

Architectural strategies justified C++ on the ESP32 and Python on the Raspberry Pi, linked by a newline-delimited JSON and telemetry UART protocol~\cite{espressif2023esp32}. \textbf{Figure~\ref{fig:sysarch}} summarised the intelligence, UART, embodiment, and physical tiers. Data flow diagrams at Level~0 (\ref{fig:dfd0}), Level~1 (\ref{fig:dfd1}), and Level~2 (\ref{fig:dfd2a}, \ref{fig:dfd2b}) traced information from sensors and cloud inference to motor outputs. Chapter~5 refines these sub-systems into detailed module-level design aligned with the implementation directories.
