darshacharya/KANDA/overleaf/chapters/chapter5.tex

% ================================================================
%  Chapter 5 — Detailed Design (KANDA)
%  Knowledge-driven Autonomous Navigation and Decision-making Agent
% ================================================================
\chapter{DETAILED DESIGN}
\label{ch:detail}

This chapter gets into the details of how KANDA actually works, piece by piece. I explain what each software module does, how they talk to each other, and what happens in a typical control cycle from sensor to motor. I also show what happens when things go wrong. This chapter is where the rubber meets the road; this is what I actually implemented and why each piece is necessary.

%-------------------------------------------------------------------
\section{High-Level Design Overview}
\label{sec:hld_overview}

The deployment comprises a Raspberry Pi running the Python package tree \textit{vision\_module/}, an ESP32 running Arduino-compatible firmware, a duplex UART link at 115,200 baud, and HTTPS access to two cloud services: Groq (text reasoning and ASR) and NVIDIA NIM (visual understanding). \textbf{Figure~\ref{fig:hld_overview}} summarises the principal deployable blocks.

\begin{figure}[H]
\centering
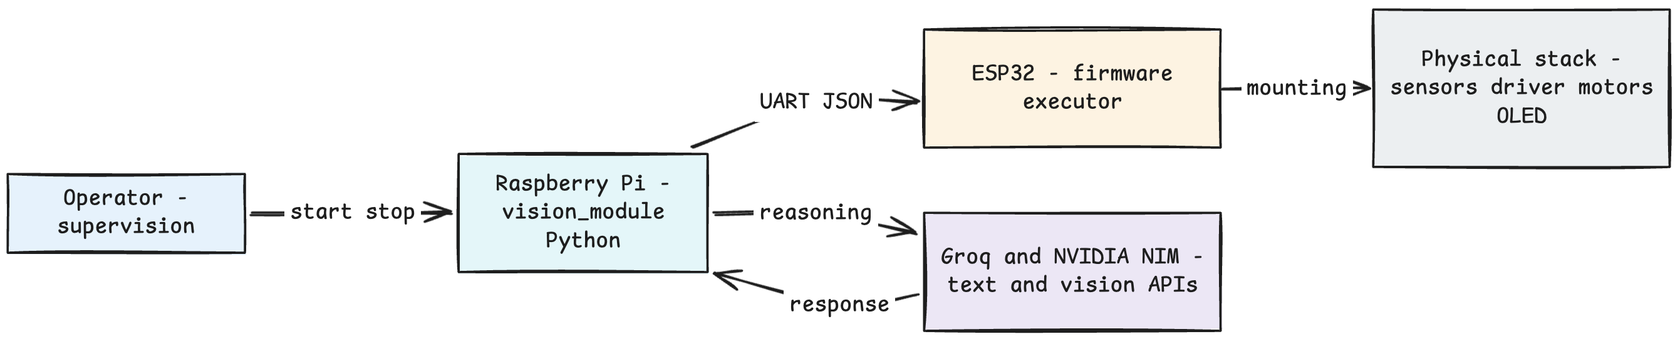
[picture p12: overleaf/images/5_1.png]

\caption[High-level deployable blocks of KANDA]{\textbf{High-level deployable blocks of KANDA.}}
\label{fig:hld_overview}
\end{figure}

\textbf{Fig.~\ref{fig:hld_overview}} shows how the operator interacts with the intelligence layer on the Pi, how the Pi exchanges newline-terminated JSON and telemetry with the ESP32 over UART, how the ESP32 connects to the physical stack, and how the Pi dispatches to Groq (for text reasoning) and NVIDIA NIM (for visual understanding) over HTTPS.

%-------------------------------------------------------------------
\section{Low-Level Design Overview}
\label{sec:lld_overview}

The Python intelligence layer is organised into configuration, serial I/O, prompt construction, LLM access, validation, and a single orchestrator entry point. \textbf{Figure~\ref{fig:lld_overview}} maps files to these roles.

\begin{figure}[H]
\centering
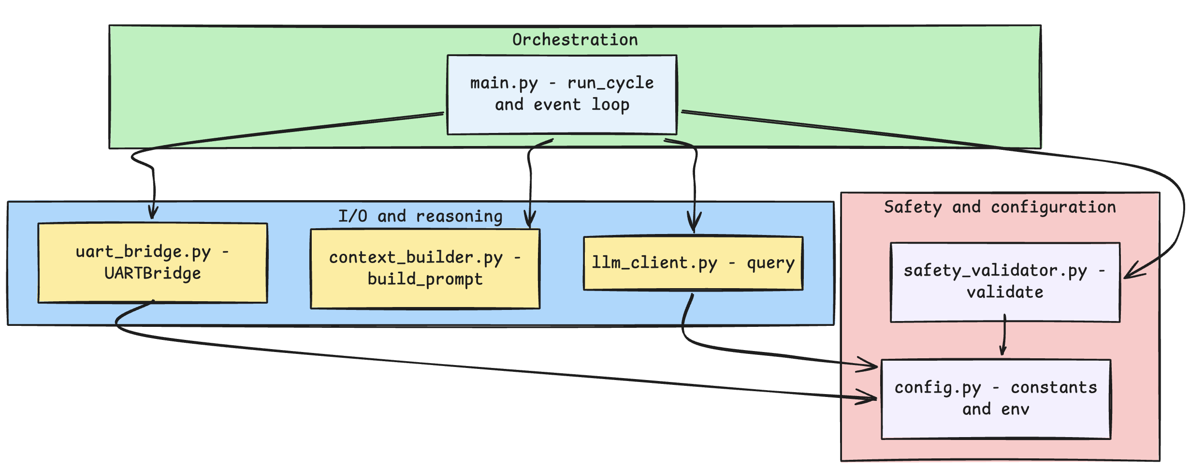
[picture p13: overleaf/images/5_2.png]

\caption[Low-level design: Python modules under ai\_layer/]{\textbf{Low-level design: Python modules under \textit{ai\_layer/}.}}
\label{fig:lld_overview}
\end{figure}

\textbf{Fig.~\ref{fig:lld_overview}} reflects the call pattern described in Section~\ref{sec:modules}: \textit{main.py} invokes UART bridge, prompt builder, LLM client, and validator; \textit{config.py} supplies shared limits and environment-backed settings to clients that depend on model id, serial port, and action sets.

%-------------------------------------------------------------------
\section{Use Case Diagram}
\label{sec:usecase}

\textbf{Figure~\ref{fig:usecase}} relates actors to the operational use cases of the deployed robot and cloud service.

\begin{figure}[htbp!]
\centering
\resizebox{0.85\textwidth}{!}{%
\begin{tikzpicture}[
  actor/.style={font=\small},
  uc/.style={draw, thick, ellipse, minimum width=3.6cm, minimum height=0.82cm, align=center, font=\footnotesize, fill=blue!6},
  arr/.style={-{Stealth[length=2mm]}, thick},
  sys/.style={draw, thick, rounded corners=6pt, minimum width=8.5cm, minimum height=8.2cm, fill=gray!3},
  node distance=0.45cm
]

\node[sys, label={[font=\small\bfseries]above:KANDA (field deployment)}] (boundary) {};

\node[uc] at (0, 3.2) (uc1) {Power \& baseline check};
\node[uc] at (0, 2.0) (uc2) {Run intelligence loop (Pi)};
\node[uc] at (0, 0.8) (uc3) {Observe status (OLED / logs)};
\node[uc] at (0, -0.4) (uc4) {Configure port / API key / model};
\node[uc] at (0, -1.6) (uc5) {AUTO\_MODE avoidance only};
\node[uc] at (0, -2.8) (uc6) {AI\_MODE LLM-guided motion};

\node[actor, left=3.1cm of boundary.west] (user) {};
\draw (user) ++(0,0.5) circle(0.25);
\draw (user) ++(0,0.25) -- ++(0,-0.5);
\draw (user) ++(-0.3,0) -- ++(0.6,0);
\draw (user) ++(0,-0.25) -- ++(-0.2,-0.4);
\draw (user) ++(0,-0.25) -- ++(0.2,-0.4);
\node[font=\small\bfseries, below=0.08cm] at ([yshift=-0.62cm]user) {Operator};

\node[actor, right=3.1cm of boundary.east] (dev) {};
\draw (dev) ++(0,0.5) circle(0.25);
\draw (dev) ++(0,0.25) -- ++(0,-0.5);
\draw (dev) ++(-0.3,0) -- ++(0.6,0);
\draw (dev) ++(0,-0.25) -- ++(-0.2,-0.4);
\draw (dev) ++(0,-0.25) -- ++(0.2,-0.4);
\node[font=\small\bfseries, below=0.08cm] at ([yshift=-0.62cm]dev) {Maintainer};

\node[actor, right=2.6cm of boundary.east, yshift=2.3cm] (gemact) {};
\draw (gemact) ++(0,0.45) circle(0.22);
\draw (gemact) ++(0,0.22) -- ++(0,-0.45);
\draw (gemact) ++(-0.25,0) -- ++(0.5,0);
\draw (gemact) ++(0,-0.22) -- ++(-0.18,-0.35);
\draw (gemact) ++(0,-0.22) -- ++(0.18,-0.35);
\node[font=\small\bfseries, below=0.06cm] at ([yshift=-0.55cm]gemact) {Groq + NVIDIA NIM};

\draw[thick] ([xshift=0.25cm]user.east) -- (uc1.west);
\draw[thick] ([xshift=0.25cm]user.east) -- (uc2.west);
\draw[thick] ([xshift=0.25cm]user.east) -- (uc3.west);
\draw[thick] ([xshift=0.25cm]user.east) -- (uc5.west);
\draw[thick] ([xshift=0.25cm]user.east) -- (uc6.west);

\draw[thick] ([xshift=-0.25cm]dev.west) -- (uc4.east);
\draw[thick] ([xshift=-0.25cm]dev.west) -- (uc2.east);

\draw[thick] ([xshift=-0.22cm]gemact.west) -- (uc2.east);
\draw[thick] ([xshift=-0.22cm]gemact.west) -- (uc6.east);

\end{tikzpicture}%
}% end resizebox
\caption[Use case diagram for KANDA deployment]{\textbf{Use case diagram for KANDA deployment.}}
\label{fig:usecase}
\end{figure}

The \textit{operator} powers the platform, starts or stops the Pi process, reads the OLED, and relies on obstacle behaviour in AUTO\_MODE or guided behaviour in AI\_MODE. The \textit{maintainer} adjusts serial device paths, credentials, and model identifiers. The \textit{Groq + NVIDIA NIM services} handle reasoning and vision whenever the intelligence loop issues inference requests.

%-------------------------------------------------------------------
\section{Component Diagram}
\label{sec:component}

\textbf{Figure~\ref{fig:component}} packages software onto the two compute nodes and shows external services.

\begin{figure}[H]
\centering
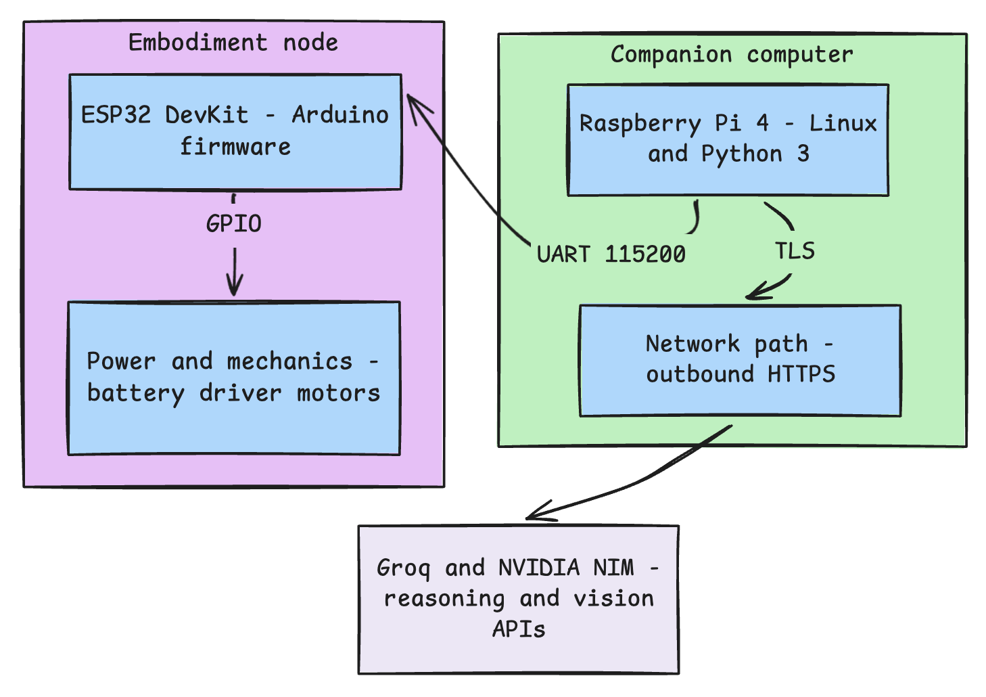
[picture p14: overleaf/images/5_4.png]

\caption[Component diagram: companion computer, embodiment node, and cloud]{\textbf{Component diagram: companion computer, embodiment node, and cloud.}}
\label{fig:component}
\end{figure}

The Raspberry Pi component hosts the entire \textit{vision\_module/} tree. The ESP32 component hosts sensing, actuation, OLED rendering, and UART framing. Groq and NVIDIA NIM are external cloud services accessed from the Pi.

%-------------------------------------------------------------------
\section{Structure Chart}
\label{sec:structure_chart}

\textbf{Figure~\ref{fig:structure_chart}} shows the static decomposition of the orchestrator and its collaborators.

\begin{figure}[H]
\centering
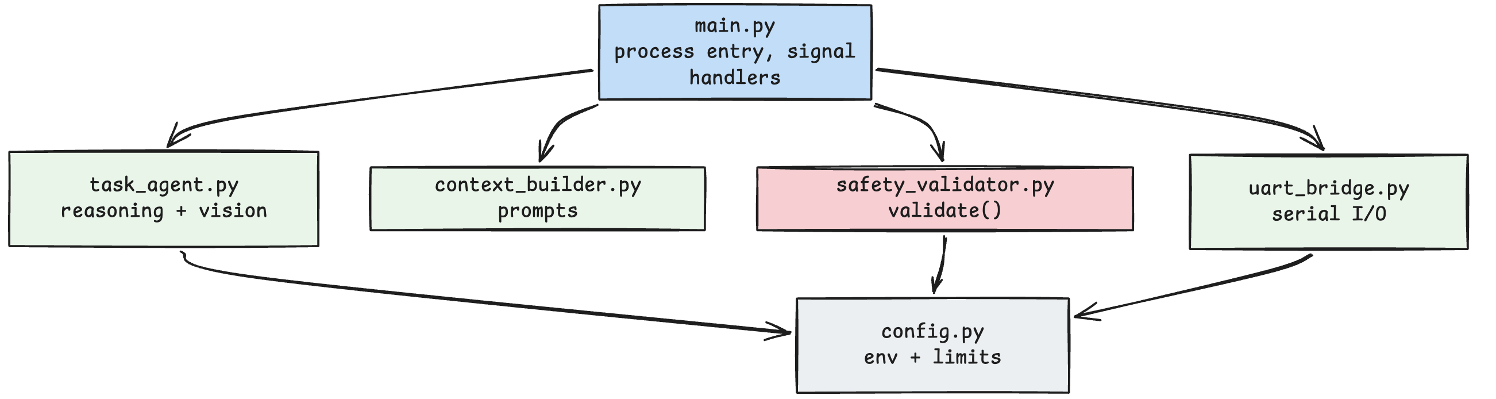
[picture p15: overleaf/images/5_5.png]

\caption[Structure chart: intelligence layer modules]{\textbf{Structure chart: intelligence layer modules.}}
\label{fig:structure_chart}
\end{figure}

Entry resolves in \textit{main.py}: an infinite loop calls \textit{run\_cycle()}, which sequences UART reads, prompt construction, LLM inference, validation, and command transmission. Shared constants and limits live in \textit{config.py}.

%-------------------------------------------------------------------
\section{Control Cycle Activity View}
\label{sec:activity}

\textbf{Figure~\ref{fig:activity_cycle}} refines the Level~2 intelligence pipeline from Chapter~\ref{ch:hld} into the conditional branches implemented in code.

\begin{figure}[H]
\centering
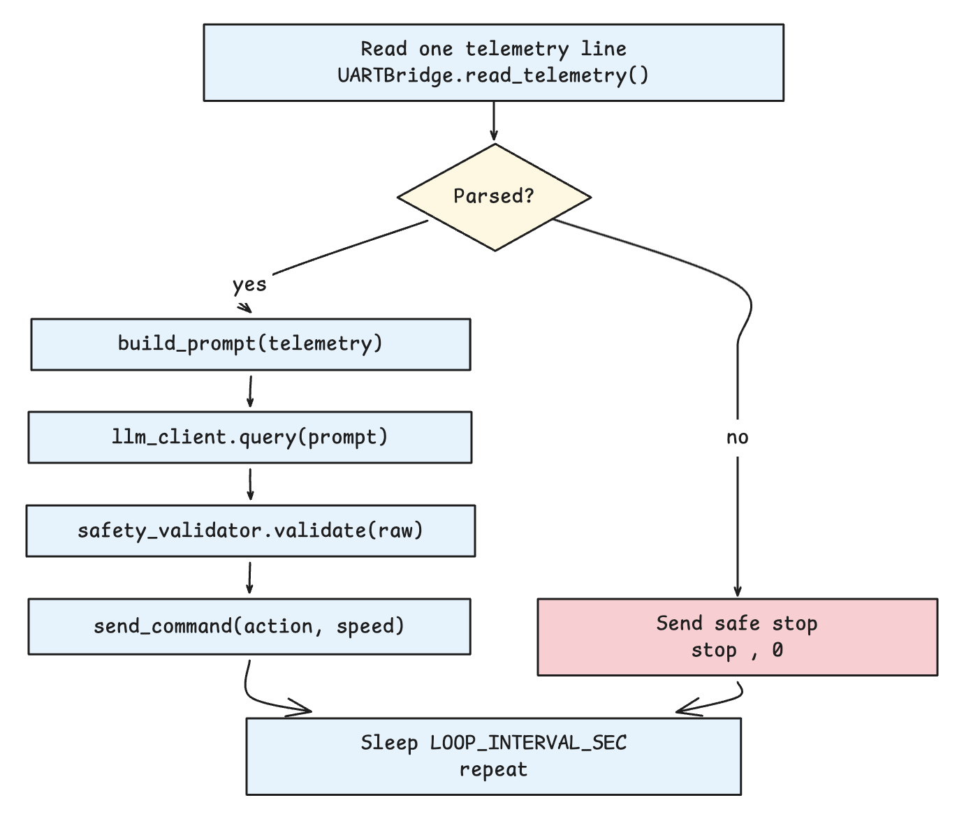
[picture p16: overleaf/images/5_6.png]

\caption[Activity view of one control cycle]{\textbf{Activity view of one control cycle.}}
\label{fig:activity_cycle}
\end{figure}

Timeouts and API exceptions on the LLM step route to the same safe-stop policy as missing telemetry before the next interval begins.

%-------------------------------------------------------------------
\section{Module Description}
\label{sec:modules}

\textbf{Table~\ref{tab:modules}} lists Python modules under \textit{ai\_layer/}. The embodiment artefact is the firmware sketch \textit{phase2\_obstacle\_avoidance.ino} described in Section~\ref{subsec:firmware}.

\begin{table}[htbp!]
\centering
\caption[Intelligence-layer modules and responsibilities]{\textbf{Intelligence-layer modules and responsibilities}}
\label{tab:modules}
\begin{tabularx}{\textwidth}{|>{\raggedright\arraybackslash}p{2.6cm}|>{\raggedright\arraybackslash}p{3.4cm}|X|}
\hline
\textbf{Module} & \textbf{File} & \textbf{Primary responsibility} \\
\hline
Orchestrator & \textit{main.py} & Control loop, signals, shutdown stop, invokes cycle steps \\
\hline
Configuration & \textit{config.py} & Serial port, baud, model id, timing, \textit{VALID\_ACTIONS}, speed bounds \\
\hline
UART bridge & \textit{uart\_bridge.py} & Open serial, parse telemetry lines, send JSON commands \\
\hline
Context builder & \textit{context\_builder.py} & Static hardware description + live sensor section + Phase~4 stubs \\
\hline
LLM client & \textit{llm\_client.py} & Configure Groq/NVIDIA NIM, generate content, extract JSON from response text \\
\hline
Safety validator & \textit{safety\_validator.py} & Type and membership checks; clamp speed; fallback stop dict \\
\hline
\end{tabularx}
\end{table}

%-------------------------------------------------------------------
\subsection[Configuration module]{Configuration module (\textit{config.py})}
\label{subsec:config}

Responsibility: Centralise tunable parameters and environment-backed secrets so other modules avoid scattering literals.

Key items: \textit{SERIAL\_PORT} (default \textit{/dev/ttyS0}), \textit{BAUD\_RATE} (115200), \textit{GROQ\_API\_KEY} and \textit{NVIDIA\_API\_KEY} from environment, \textit{VALID\_ACTIONS} as a Python set of seven string verbs, \textit{SPEED\_MIN}/\textit{SPEED\_MAX} (0--255), \textit{LOOP\_INTERVAL\_SEC}, \textit{LLM\_TIMEOUT\_SEC}, and \textit{DEFAULT\_SPEED} when the model omits speed.

%-------------------------------------------------------------------
\subsection[UART bridge module]{UART bridge module (\textit{uart\_bridge.py})}
\label{subsec:uart}

Responsibility: Encapsulate pyserial lifecycle and the ASCII protocols agreed with firmware.

Interface: Class \textit{UARTBridge} exposes \textit{connect()}, \textit{disconnect()}, context-manager support, and \textit{read\_telemetry()}. The send method serialises a one-line JSON object. The read method blocks up to \textit{SERIAL\_TIMEOUT}, decodes UTF-8, and parses telemetry lines into a dictionary.

Notes: A short sleep after opening the port accommodates ESP32 reset behaviour.

%-------------------------------------------------------------------
\subsection[Context builder module]{Context builder module (\textit{context\_builder.py})}
\label{subsec:ctx}

Responsibility: Concatenate a static hardware-and-policy preamble with formatted front/left/right readings so the LLM receives explicit affordances and safety hints on every call~\cite{ahn2022saycan}.

Interface: \textit{build\_prompt(telemetry, user\_speech=None, image\_b64=None)} returns one prompt string. Optional speech and image parameters are reserved for Phase~4 multimodal extensions; the LLM client already accepts \textit{image\_b64} for future attachment.

%-------------------------------------------------------------------
\subsection[LLM client module]{LLM client module (\textit{llm\_client.py})}
\label{subsec:llm}

Responsibility: Initialise the Groq and NVIDIA NIM clients (OpenAI-compatible API) once per process, invoke inference with low temperature (0.1) and short \textit{max\_tokens} (256), and recover a JSON object from arbitrary response text.

Parsing strategy: Prefer fenced markdown JSON if present; otherwise extract the first balanced brace segment and pass it to \textit{json.loads}. Failures surface as \textit{ValueError} for the orchestrator to translate into safe stop.

%-------------------------------------------------------------------
\subsection[Safety validator module]{Safety validator module (\textit{safety\_validator.py})}
\label{subsec:val}

Responsibility: Guarantee that only whitelisted actions and bounded speeds reach \textit{send\_command}; never raise, always return a usable dictionary~\cite{huang2023grounded}.

Rules: Reject non-dicts and unknown actions with fallback \textit{action}\,=\,\textit{stop} and \textit{speed}\,=\,0; coerce \textit{speed} with \textit{int()}; clamp to $[0,255]$ with logging when out of range.

%-------------------------------------------------------------------
\subsection[Orchestrator]{Orchestrator (\textit{main.py})}
\label{subsec:main}

Responsibility: Own the process lifecycle: configure logging, register SIGINT/SIGTERM handlers that send stop, open UART, loop with \textit{time.sleep(LOOP\_INTERVAL\_SEC)}, catch unexpected exceptions per cycle and issue stop, and disconnect cleanly.

Cycle ordering: Matches \textbf{Fig.~\ref{fig:activity_cycle}}: read telemetry; if missing, stop and skip LLM; else build prompt, query Groq or NVIDIA NIM (errors treated like invalid output), validate, transmit.

%-------------------------------------------------------------------
\subsection[Embodiment firmware]{Embodiment firmware (\textit{phase2\_obstacle\_avoidance.ino})}
\label{subsec:firmware}

Responsibility: Run the real-time sense--act loop on the ESP32: trigger/echo ultrasonic measurements with \textit{pulseIn}, map distances through motor primitives (\textit{forward}, pivots, etc.) via TB6612FNG direction pins and LEDC PWM, refresh the SSD1306 via I\textsuperscript{2}C, and exchange newline-terminated messages over \textit{Serial}.

Modes: \textit{AI\_MODE} activates when a valid JSON line arrives (\textit{ArduinoJson} parse); \textit{AUTO\_MODE} executes distance-threshold rules when no JSON is seen for \textit{AI\_TIMEOUT\_MS} (5000\,ms). Constants such as \textit{OBSTACLE\_DIST} and \textit{WALL\_DIST} tune avoidance aggressiveness independently of the LLM policy on the Pi~\cite{brooks1986robust}.

%-------------------------------------------------------------------
\section{Phase~4 Multimodal Architecture}
\label{sec:phase4_arch}

Phase~4 extends the intelligence layer with voice, vision, and remote interaction capabilities orchestrated by a 7-state event-driven machine.

%-------------------------------------------------------------------
\subsection{7-State Machine}
\label{subsec:statemachine}

\textbf{Figure~\ref{fig:state_machine_ch5}} shows the state-transition graph for the Phase~4 orchestrator. The machine begins in IDLE and transitions through LISTENING, THINKING, ACTING, SEARCHING, SPEAKING, and REPORTING states. A global cancel path (triggered by obstacle detection or an explicit stop command) can abort any active state and return the system to IDLE, ensuring that safety is never blocked by an ongoing task.

\begin{figure}[H]
\centering
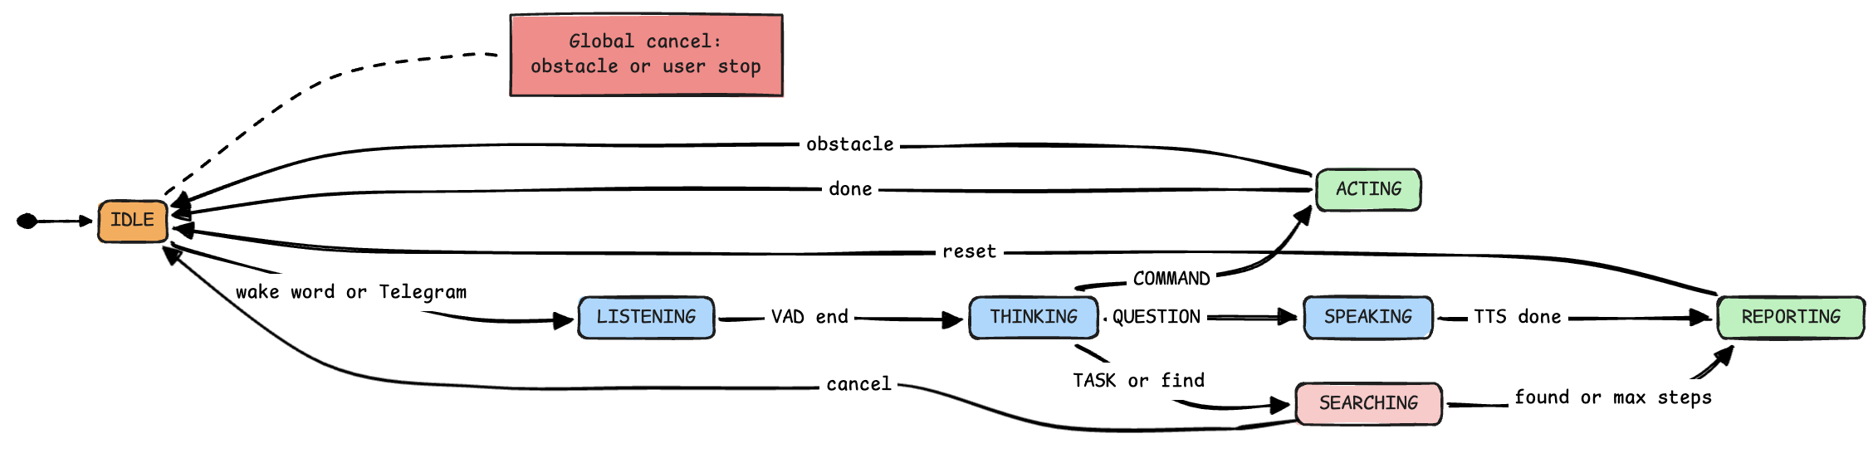
[picture p17: overleaf/images/5_7.png]

\caption[7-state event-driven machine for the Phase 4 multimodal agent]{\textbf{7-state event-driven machine for the Phase~4 multimodal agent.}}
\label{fig:state_machine_ch5}
\end{figure}

Four concurrent daemon threads support the state machine: (1)~openWakeWord~\cite{openwakeword2024} detector running offline ONNX inference at 8\% CPU, (2)~ESP32 heartbeat monitor parsing telemetry and propagating obstacle events, (3)~Telegram bot long-polling, and (4)~TTS worker queue draining speech requests.

%-------------------------------------------------------------------
\subsection{ReAct Search Algorithm}
\label{subsec:react_search}

For ``find'' tasks, a specialised ReAct loop~\cite{yao2023react} (\textbf{Fig.~\ref{fig:react_flow}}) combines vision, movement, and semantic memory. Scene descriptions are compared using Ratcliff--Obershelp string similarity~\cite{ratcliff1988} to prevent revisiting previously explored locations.

\begin{figure}[H]
\centering
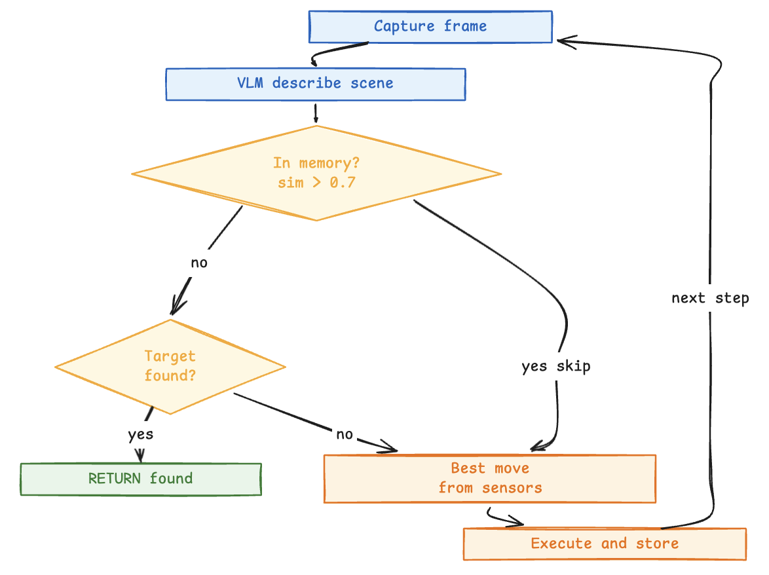
[picture p18: overleaf/images/5_8.png]

\caption[ReAct search flowchart with semantic memory]{\textbf{ReAct search flowchart with semantic memory.}}
\label{fig:react_flow}
\end{figure}

%-------------------------------------------------------------------
% \section{Summary}
% \label{sec:ch5summary}

% This chapter detailed KANDA's software structure from high-level deployment topology down to individual module interfaces. \textbf{Figures~\ref{fig:hld_overview}}--\ref{fig:component} positioned the Pi intelligence layer, ESP32 embodiment node, UART link, and cloud LLM services within the overall system boundary. \textbf{Figures~\ref{fig:structure_chart}} and~\ref{fig:activity_cycle} traced module ownership and the sequencing of one control cycle from telemetry ingestion through validation to motor command transmission.
