darshacharya/KANDA/overleaf/paper/kanda.tex

% ====================================================================
%  KANDA -- IEEE Conference Paper (Phase 4)
%  Compile: pdflatex -> pdflatex (x2 if bib added later)
% ====================================================================
\documentclass[conference]{IEEEtran}
\IEEEoverridecommandlockouts

\usepackage{cite}
\usepackage{amsmath,amssymb,amsfonts}
\usepackage{newtxtext,newtxmath}
\usepackage{algorithm}
\usepackage{algorithmic}
\usepackage{graphicx}
\graphicspath{{./}{../images/}}
\usepackage{textcomp}
\usepackage{booktabs}
\usepackage{array}
\usepackage{tabularx}
\usepackage{multirow}
\usepackage{enumitem}
\usepackage{xcolor}
\usepackage{listings}
\usepackage{float}
\usepackage{microtype}
\usepackage[hidelinks]{hyperref}

% Fixed-size figure slot, aspect ratio preserved (#1=width, #2=height)
\newcommand{\slotfig}[3]{%
  \begin{minipage}[c][#2][c]{#1}%
    \centering
    %
  \end{minipage}%
}

% Full-width tables in IEEE single-column floats
\newcolumntype{Y}{>{\raggedright\arraybackslash}X}
\newcolumntype{C}{>{\centering\arraybackslash}X}
\newcolumntype{R}{>{\raggedleft\arraybackslash}X}

\lstset{
  basicstyle=\ttfamily\scriptsize,
  breaklines=true,
  breakatwhitespace=false,
  breakautoindent=true,
  postbreak=\mbox{\textcolor{gray}{$\hookrightarrow$}\space},
  frame=single,
  numbers=none,
  captionpos=b,
  aboveskip=6pt,
  belowskip=2pt,
  belowcaptionskip=2pt,
  keepspaces=true,
  columns=fullflexible,
}

\def\BibTeX{{\rm B\kern-.05em{\sc i\kern-.025em b}\kern-.08em
    T\kern-.1667em\lower.7ex\hbox{E}\kern-.125emX}}

\newcommand{\safe}{\texttt{stop}}
\newcommand{\groq}{\textit{Groq Llama 3.3}}
\newcommand{\nvidia}{\textit{NVIDIA NIM Llama 3.2 Vision}}

% ====================================================================
\begin{document}

\title{KANDA: A Multimodal Embodied Robot Agent Driven by\\Large Language Models for Hardware-Conscious Command Generation}

\author{%
\IEEEauthorblockN{Sudarshan T S}
\IEEEauthorblockA{%
\textit{M.Tech in Information Technology}\\
\textit{Dept.\ of Information Science and Engineering}\\
\textit{RV College of Engineering }\\
Bengaluru 560059, India\\
\texttt{sudarshants.sit24@rvce.edu.in}}
\and
\IEEEauthorblockN{Sushmitha N}
\IEEEauthorblockA{%
\textit{Assistant Professor}\\
\textit{Dept.\ of Information Science and Engineering}\\
\textit{RV College of Engineering }\\
Bengaluru 560059, India\\
\texttt{sushmithan@rvce.edu.in}}
}

\maketitle

% ====================================================================
\begin{abstract}
\textbf{KANDA} is a low-budget multimodal embodied agent built for under~\$77 using ESP32, Raspberry Pi~4, and a camera module.
It supports named-object search, indoor navigation, and both speech and keyboard input.
\groq{} handles language reasoning while \nvidia{} provides visual understanding.
A three-layered control architecture based on Brooks' subsumption model is employed: (i)~a body-context prompt grounding the LLM in live sensor data and action limits, (ii)~a deterministic critic on the Pi mapping LLM output to legal commands or \safe{}, and (iii)~a firmware reflex on the ESP32 halting motion when ultrasonic range falls below 15\,cm, independent of cloud latency.
Ablation over 10 trials per condition shows that removing scene context leads to 15\% unsafe plans, absence of episodic memory causes 60\% redundant search steps, and disabling the firmware stop results in 30\% near-miss events.
On 60 voice utterances, macro-averaged intent F1 is 0.94, visual search succeeds in 8 of 10 trials, and all eight injected faults terminate safely.
\end{abstract}

\begin{IEEEkeywords}
embodied AI, deliberative--critic--reflex architecture, vision-language grounding, command validation, episodic visual search, layered safety, ESP32, Raspberry Pi
\end{IEEEkeywords}

% ====================================================================
\section{Introduction}
\label{sec:intro}
% ====================================================================

Embodied artificial intelligence has advanced considerably, but the systems demonstrating the most impressive capabilities tend to require hardware and data resources beyond reach of most research groups. PaLM-E~\cite{driess2023palme} employs a 562-billion-parameter model trained on massive multimodal corpora. SayCan~\cite{ahn2022saycan} targets mobile manipulators costing upwards of one hundred thousand dollars and requires tens of thousands of demonstration episodes. RT-1~\cite{brohan2022rt1} and RT-2~\cite{brohan2023rt2} depend on large-scale teleoperation datasets and web-scale fine-tuning that presuppose institutional compute budgets. This paper asks: can comparable behaviours, including voice interaction, indoor navigation, visual object search, and collision avoidance, run on commodity hardware costing under eighty dollars with zero robot-specific training?

\begin{figure}[t]
\centering
\slotfig{0.9\columnwidth}{6.2cm}{kanda_robot}
\caption{KANDA prototype}
\label{fig:proto}
\end{figure}

Building such a system exposes four engineering gaps. First, the absence of body context: when an LLM controls a robot without knowing what movements are physically possible or what sensors currently report, it produces infeasible commands~\cite{ahn2022saycan,vemprala2024chatgpt}. Second, intent ambiguity: ``go forward'' requires a validated motor command, while ``find my bottle'' requires a multi-step visual search loop inspired by Inner Monologue~\cite{huang2022innermonologue} and ReAct~\cite{yao2023react}. Third, model garbage: the language model often produces corrupted outputs, markdown code fences, or hallucinated action names~\cite{huang2023grounded}. Fourth, timing mismatch: a physical obstruction can appear in 100\,ms~\cite{brooks1986robust}, whereas cloud inference takes 1.5 to 4 seconds.

KANDA addresses these gaps through a body-context assembler grounding every model call in live hardware state, an intent router classifying utterances before dispatch, a validator function $V$ mapping any model output to a safe motor command, and firmware reflexes on the ESP32 halting motion independently of the Pi or cloud. The entire system runs on a Raspberry Pi~4 paired with an ESP32, communicating over a 115{,}200-baud UART link, with cloud inference handled by free-tier API calls to Groq and NVIDIA NIM. No model fine-tuning, reinforcement learning, or demonstration data collection is required at any stage.

This paper makes six contributions: (1)~a fully functional multimodal embodied agent built for under \$77 supporting voice, vision, text, and Telegram interaction; (2)~a body-context grounding scheme with a shared action vocabulary consistent across prompt, validator, and firmware; (3)~an intent classification mechanism paired with episodic visual search; (4)~ablation evidence for a deliberative--critic--reflex safety architecture; (5)~a seven-state machine design preserving fast obstacle handling despite slow cloud calls; (6)~demonstration modes suitable for classroom and exhibition deployment.

% ====================================================================
\section{Related Work}
\label{sec:related}
% ====================================================================

The problem of grounding language models in physical robot capabilities has been approached from several directions. SayCan~\cite{ahn2022saycan} learns affordance functions from thousands of demonstrations to score which actions are physically feasible. KANDA takes a different approach by embedding affordances directly in the prompt at zero training cost, making the model aware of valid actions, speed limits, and current sensor measurements. Chain-of-thought prompting~\cite{wei2022cot} improves model executability, and Huang et al.~\cite{huang2022zeroshot} showed that language models serve as zero-shot planners when prompted properly. The body-context method I propose builds on this insight by incorporating telemetry at every inference step.

Several systems compose LLM output into executable control programs. Socratic Models~\cite{zeng2023socratic} chain multiple foundation models, Code as Policies~\cite{liang2023code} generates Python control code, and ProgPrompt~\cite{singh2023progprompt} frames tasks as program synthesis. These produce complex outputs difficult to validate at runtime. KANDA restricts the interface to single-line JSON commands validated before UART transmission. Inner Monologue~\cite{huang2022innermonologue} and ReAct~\cite{yao2023react} interleave observations with model decisions in a closed loop. The visual search in KANDA draws on this principle but uses VLM scene descriptions with episodic deduplication memory to prevent revisiting explored locations.

On safety, Amodei et al.~\cite{amodei2016safety} argued that structural safeguards are necessary beyond scaling model capabilities. Brooks~\cite{brooks1986robust} established the subsumption architecture where fast reactive layers override slower deliberative layers. The Dynamic Window Approach~\cite{fox1997dwa} informs the ultrasonic threshold design. Edge computing surveys~\cite{bonomi2012fog,shi2016edge} motivate placing safety-critical logic on the microcontroller. KANDA makes the critic layer explicit and deterministic, paired with a hardware reflex that cannot be circumvented through prompt engineering or hallucination.

% ====================================================================
\section{Formal Problem Definition}
\label{sec:formal}
% ====================================================================

Before describing the system architecture, I define the constraints that any valid command must satisfy. The robot's action vocabulary consists of seven motor primitives: $\mathcal{A} = \{\text{forward}, \text{backward}, \text{left}, \text{right}, \text{slight\_left}, \text{slight\_right}, \text{stop}\}$. Each command pairs one of these actions with an integer speed value drawn from the range $[0, 255]$, which corresponds to the PWM duty cycle applied to the motor driver.

\textbf{Definition 1 (Safe command).}
A command $c = (a, s)$ where $a$ denotes the action and $s$ denotes the speed is safe if and only if:
\begin{equation}
\label{eq:safety}
a \in \mathcal{A} \;\wedge\; s \in \mathbb{Z} \;\wedge\; 0 \leq s \leq 255
\end{equation}

\textbf{Definition 2 (Critic / validator).}
The validator is a total function $V:\text{Any} \to \mathcal{A} \times [0,255]$ satisfying:
\begin{equation}
\label{eq:validator}
\forall\, x \in \text{Any}:\; V(x) \text{ is safe per Eq.~\eqref{eq:safety}} \;\wedge\; V(x) \text{ terminates}
\end{equation}
In practice, any unrecognised action maps to \safe{}, any non-integer speed maps to \safe{}, and out-of-range numeric speeds are clamped to $[0, 255]$ before transmission.

\textbf{Definition 3 (Timing constraint).}
The firmware reflex latency $t_r$ must satisfy $t_r \ll t_c$ where $t_c$ is the cloud round-trip time:
\begin{equation}
\label{eq:timing}
t_r \approx 47\,\text{ms (mean)}, \quad
t_c \in [1500, 4000]\,\text{ms}, \quad
\frac{t_c}{t_r} \approx 40
\end{equation}
The ESP32 firmware runs a cooperative loop at approximately 10\,Hz. Within each 100\,ms iteration, the reflex logic reads all three ultrasonic sensors and evaluates the stopping condition without waiting for any Pi or cloud response. This separation ensures that network failures or API timeouts cannot delay the safety-critical path.

% ====================================================================
\section{System Design}
\label{sec:arch}
% ====================================================================

\subsection{Three Tiers}

The system is organised into three processing tiers, illustrated in Fig.~\ref{fig:arch}. Each tier is designed to reach a safe state independently if the tiers above it fail or become unreachable. This fail-safe independence is the central architectural principle: power loss at any higher tier must never leave a lower tier in an unsafe motion state.

\begin{figure}[t]
\centering
\slotfig{0.9\columnwidth}{5.5cm}{architecture}
\caption{Three-tier layout: cloud deliberation, edge critic and state machine, device reflex and sensing.}
\label{fig:arch}
\end{figure}

The \textbf{cloud tier} handles all language and vision reasoning via Groq for text and NVIDIA NIM for vision, with temperature set to 0.1 for classification tasks. It performs scene analysis, intent classification, and JSON action generation. Latency ranges from 1.5 to 4 seconds, and all outputs are treated as untrusted until validated by the critic.

The \textbf{edge tier} runs on the Raspberry Pi~4 and hosts the Python-based vision module. It contains the state machine, the body-context builder, the plan executor, the openWakeWord~\cite{openwakeword2024} wake phrase detector trained on \emph{Hey Kanda}, the gTTS speech synthesis output, and the Telegram message polling loop.

The \textbf{device tier} runs on the ESP32 microcontroller. It samples three HC-SR04 ultrasonic sensors on each iteration of its main loop, parses one incoming JSON command per line from the UART, and applies an emergency stop whenever the robot is moving forward and the front sensor reports a range below 15\,cm.

These three tiers map onto a deliberative--critic--reflex decomposition mirroring Brooks' subsumption architecture~\cite{brooks1986robust}: the cloud proposes actions conditioned on body context; the edge validator $V$ rejects or clamps every command before transmission (Listing~\ref{lst:validator}); the device halts motors and reports \texttt{OBSTACLE} independently of cloud latency. A heartbeat thread on the Pi (100\,ms interval) forwards obstacle events to ensure non-blocking THINKING and SEARCHING states.

\subsection{Wire Communication Protocol}

The Pi and ESP32 communicate via UART at 115{,}200 baud using a text-based protocol. The Pi sends single JSON objects per line (e.g., {\scriptsize\texttt{\{"action":"forward","speed":120,"state":"searching"\}}}). The ESP32 responds with telemetry strings (e.g., {\scriptsize\texttt{F:30.5 L:21.0 R:16.4 -> FORWARD}}). The \texttt{state} field in downlink messages allows the ESP32 to adjust its LED display and buzzer feedback based on the current system mode. This plain-text approach allows debugging with any serial monitor and avoids binary framing complexity that would complicate fault diagnosis during development.

% ====================================================================
\section{Mechanisms}
\label{sec:methodology}
% ====================================================================

\subsection{Body-Context Assembler}
\label{sec:bodyctx}

Before each model inference call, the body-context assembler produces a textual block containing the latest VLM scene description, movement capabilities, speed constraints, current sensor data with proximity alarms, and recent action history. Listing~\ref{lst:bodyctx} shows an example. The block is regenerated from scratch on every call rather than cached, ensuring the model always reasons over the most recent sensor state. Including the last three executed actions prevents the model from issuing redundant repeated commands when the robot has already reached the desired heading or position.

\begin{lstlisting}[caption={Body-context block (rebuilt each inference call)},
  label={lst:bodyctx}, float=tp]
You are a robot with two wheels called KANDA.
Capabilities include forward, reverse, left, right,
  slight left, slight right, and stop.
  Speed range: from 0 to 255. Camera resolution: 640x480.
Restrictions: only approximate turns, no stairs or arm.
Sensors:
  Left sensor = 18.4 cm  WARNING: imminent collision
  Right sensor = 62.0 cm
  Left sensor = 25.3 cm
Scene: "A desk with laptop and water bottle."
Final actions: ["forward," "forward," "slight_left"]
State: Searching.
"I need to find my water bottle." User stated.
JSON ONLY in your answer please.
\end{lstlisting}

\subsection{Task Agent and Episodic Visual Search}
\label{sec:search}

Each utterance is classified into one of four classes: \texttt{COMMAND} for motion, \texttt{QUESTION} for scene queries, \texttt{TASK} for complex goals like finding an object, and \texttt{UNKNOWN} for unrecognised inputs. For \texttt{TASK} utterances, the algorithm generates a JSON list of up to 50 steps including actions such as move, talk, \texttt{capture\_check}, \texttt{loop\_while}, and wait.

The search routine (Algorithm~\ref{alg:search}) repeatedly captures images, obtains VLM descriptions, filters for the target using Ratcliff--Obershelp similarity~\cite{ratcliff1988} with episodic memory (threshold $\tau{=}0.7$, reduced to 0.5 after five revisits), and selects movement based on ultrasonic geometry. This approach extends the ReAct~\cite{yao2023react} paradigm with episodic deduplication.

\begin{algorithm}[t]
\caption{Episodic visual search (VLM-driven)}
\label{alg:search}
\begin{algorithmic}[1]
\REQUIRE target $T$, max steps $N{=}20$
\STATE $\mathcal{M} \leftarrow \emptyset$; $\tau \leftarrow 0.7$; $\mathit{skip} \leftarrow 0$
\FOR{$i = 1$ \TO $N$}
  \STATE $f \leftarrow \text{capture()}$;
         $s \leftarrow \text{VLM.describe}(f)$
  \IF{$\exists\, m \in \mathcal{M}: \text{sim}(s, m) > \tau$}
    \STATE $\mathit{skip} \leftarrow \mathit{skip} + 1$
    \IF{$\mathit{skip} > 5$}
      \STATE $\tau \leftarrow 0.5$
    \ENDIF
    \STATE \textbf{continue}
  \ENDIF
  \STATE $\mathcal{M} \leftarrow \mathcal{M} \cup \{s\}$; $\mathit{skip} \leftarrow 0$
  \IF{$\text{VLM.check}(f, T) = \textsc{yes}$}
    \RETURN \textsc{found}, $s$
  \ENDIF
  \STATE execute(heuristic\_move(sensors)); sleep
\ENDFOR
\RETURN \textsc{not\_found}
\end{algorithmic}
\end{algorithm}

\subsection{Safety Validator (Critic)}
\label{sec:validator}

The safety validator is the deterministic critic layer between language model output and UART transmission. It enforces four invariants on every command:

\begin{align}
\text{I}_1&: \; r \text{ is a dict with keys } \texttt{action},\, \texttt{speed} \label{inv:dict}\\
\text{I}_2&: \; r[\texttt{action}] \in \mathcal{A} \quad(\text{else } \to \safe{}) \label{inv:action}\\
\text{I}_3&: \; r[\texttt{speed}] \in \mathbb{Z} \quad(\text{else } \to \safe{}) \label{inv:int}\\
\text{I}_4&: \; r[\texttt{speed}] = \text{clamp}(r[\texttt{speed}],\, 0,\, 255) \label{inv:range}
\end{align}

\begin{lstlisting}[language=Python, caption={Critic $V$: total, safe output (matches \texttt{safety\_validator.py})},
  label={lst:validator}, float=tp]
SAFE = {"action": "stop", "speed": 0}
def validate(cmd):
    if not isinstance(cmd, dict):  return SAFE
    action = cmd.get("action")
    speed  = cmd.get("speed", 100)
    if action not in VALID_ACTIONS: return SAFE
    try:    speed = int(speed)
    except: return SAFE
    speed = max(0, min(255, speed))
    return {"action": action, "speed": speed}
\end{lstlisting}

\subsection{Firmware Reflex and Pi Cancel}
\label{sec:reflex}

On each ESP32 loop iteration, the firmware checks whether the robot is moving forward. If the front ultrasonic sensor reports distance $d_F < 15$\,cm, it immediately zeros motor output, transitions to \texttt{obstacle} state, and includes \texttt{OBSTACLE} in telemetry. Mean latency from detection to halt is $47 \pm 21$\,ms (Table~\ref{tab:timing}), dominated by the 100\,ms loop period rather than cloud round-trip time. On the Pi, a heartbeat thread at 100\,ms intervals reads telemetry, updates body-context structures, and sets a global cancel flag causing any THINKING or SEARCHING state to exit without waiting for its cloud call.

\subsection{Seven-State Machine}
\label{sec:fsm}

The Pi implements a seven-state machine: \texttt{IDLE}, \texttt{LISTENING}, \texttt{THINKING}, \texttt{ACTING}, \texttt{SEARCHING}, \texttt{SPEAKING}, and \texttt{REPORTING} (Fig.~\ref{fig:statemachine}). Four concurrent threads handle wake word detection, ESP32 telemetry, Telegram polling, and TTS output. No cloud call or search step blocks the reflex handling path; the cancel mechanism is event-driven from inbound telemetry, propagating obstacle detection within one heartbeat period.

\begin{figure}[t]
\centering
\slotfig{0.9\columnwidth}{8.0cm}{statemachine}
\caption{Seven-state machine with global cancel on obstacle detection or stop command.}
\label{fig:statemachine}
\end{figure}

% ====================================================================
\section{Evaluation}
\label{sec:results}
% ====================================================================

\subsection{Experimental Protocol}
\label{sec:protocol}

All experiments ran in a $3\times 4$\,m indoor lab (desks, chairs, bookshelf; ambient noise $<$40\,dB; local Wi-Fi) using \groq{} for text, \nvidia{} for vision, firmware \texttt{firmware\_phase4.ino}, and Python~3.10+ on Pi OS. Metrics: \emph{Action correct} (motion consistent with request), \emph{Intent correct} (label matches program categories), \emph{Failure} (dangerous motion, parse error, timeout), \emph{Near-miss} (object within 15\,cm during forward motion). Six paraphrase types with ten trials each ($n{=}60$) for voice. Visual search: ten trials from five item categories, target found in $<$20 motions. Ablation: one layer blocked per condition ($n{=}10$; Table~\ref{tab:ablation}). Baselines: ESP32 \texttt{AUTO\_MODE} (rule-based avoidance, no voice) and prompt-only (validator bypassed, offline playback of 50 outputs). Hardware cost in Table~\ref{tab:bom}.

\subsection{Voice Commands}

Table~\ref{tab:voice} reports recognition and execution results for six utterance classes.

\begin{table}[t]
\caption{Voice command evaluation ($n{=}10$ per utterance class).}
\label{tab:voice}
\centering
\renewcommand{\arraystretch}{1.05}
\begin{tabularx}{\columnwidth}{@{}YCC@{}}
\toprule
\textbf{Utterance class} & \textbf{Intent correct} & \textbf{Outcome correct} \\
\midrule
``Go forward'' & 10/10 & 10/10 \\
``Turn left'' & 10/10 & 10/10 \\
``Stop'' & 10/10 & 10/10 \\
``What do you see?'' & 9/10 & 9/10 \\
``Find my bottle'' & 10/10 & 8/10 \\
``Dance for me'' & 8/10 & 7/10 \\
\bottomrule
\end{tabularx}
\end{table}

Macro-averaged precision, recall, and F1 across all six classes are 0.95, 0.93, and 0.94 respectively. The openWakeWord~\cite{openwakeword2024} model trained on ``Hey Kanda'' (\texttt{hey\_kanda.onnx}) achieved $<$2\% false positive rate and $>$95\% true positive rate within one metre over 30 minutes of idle listening. The two misclassified intent cases in ``Dance for me'' arose because the model occasionally interpreted creative requests as general questions rather than task-class utterances. The single ``What do you see?'' failure occurred when background noise corrupted the STT transcription, producing a partial string that the intent classifier could not categorise.

\subsection{Visual Object Search}

The robot located target items in 8 of 10 attempts, averaging seven search steps per success. The two failures occurred when furniture fully occluded the target from all reachable vantage points within the 20-step limit. The adaptive threshold $\tau$ decreased from 0.7 to 0.5 three times when encountering visually similar environments. Items placed at floor level or partially hidden behind chair legs proved more challenging than items on desks or shelves, as the fixed camera height (approximately 25\,cm) limits the effective field of view for ground-level objects. Among the five item categories tested (bottle, book, backpack, mug, phone), the backpack category had the highest first-attempt detection rate due to its distinctive visual features in VLM descriptions.

\subsection{Fault Injection}

Eight deliberate failure scenarios (Table~\ref{tab:faults}) verified safe behaviour under adverse conditions. In every case, the robot stopped within 200\,ms of fault onset with no continued motion toward obstacles. The most revealing scenario was API key revocation during an active search: the validator received a non-JSON error response from the cloud, correctly mapped it to \safe{}, and the robot halted gracefully while speaking an error message. The USB-unplug test confirmed that the ESP32 continues autonomous obstacle avoidance even when the Pi is completely disconnected, validating the independence of the device-tier safety layer.

\begin{table}[t]
\caption{Fault injection ($n{=}1$ trial per scenario).}
\label{tab:faults}
\centering
\renewcommand{\arraystretch}{1.05}
\begin{tabularx}{\columnwidth}{@{}YY@{}}
\toprule
\textbf{Situation} & \textbf{Observations made} \\
\midrule
Obstacle detected along path & ESP32 reflex halts in 47\,ms on average (Table~\ref{tab:timing}) \\
Cloud API timeout (15\,s) & Error message spoken; return to idle \\
API rate limit & Backoff 5\,s; retry works \\
Camera obstructed & Rejected frame ($<$5\,KB); pass skipped \\
API key revoked & Validator emits \safe{}; camera now idle \\
USB unplugged & Pi goes idle; ESP32 sensor continues reporting \\
Heavy noise in STT & Error message; idle \\
Image with no target & No objects found \\
\bottomrule
\end{tabularx}
\end{table}

\subsection{Ablation}

Each architectural component was blocked individually and evaluation repeated. Table~\ref{tab:ablation} shows failure probabilities with 95\% confidence intervals ($n{=}10$ per condition). The confidence intervals were computed using the Wilson score method appropriate for small-sample binomial proportions.

\begin{table}[t]
\caption{Ablation: various failure modes for each removed component ($n{=}10$, 95\% CI).}
\label{tab:ablation}
\centering
\renewcommand{\arraystretch}{1.05}
\begin{tabularx}{\columnwidth}{@{}YCC@{}}
\toprule
\textbf{Layer removed} & \textbf{Failure probability} & \textbf{Dominant failure mode} \\
\midrule
Camera scene in prompt & 15\% $\pm$ 7\% & Plan for invisible obstacles \\
Episodic memory & 60\% $\pm$ 10\% & Return to past locations \\
Obstacle warnings in prompt & 20\% $\pm$ 8\% & Forward near wall \\
Action vocabulary in prompt & 30\% $\pm$ 9\% & Non-JSON / bad action \\
ESP32 firmware reflex & 30\% $\pm$ 9\% & Near-miss (see \S\ref{sec:protocol}) \\
\bottomrule
\end{tabularx}
\end{table}

To validate the critic layer independently, I replayed 50 logged model responses through the prompt-only baseline (validator bypassed). This revealed that 42\% of raw outputs were structurally unsafe (invalid actions, non-numeric speeds, malformed JSON), whereas after passing through $V$, zero transmitted commands violated safety invariants. The \texttt{AUTO\_MODE} baseline avoided all collisions in 10 UART-loss trials, confirming firmware-level safety works independently, but could not follow voice-directed goals.

KANDA is, to my knowledge, the only implementation combining explicit critic and reflex safety layers on sub-\$100 commodity hardware with zero robot-specific training.

\subsection{Timing and Cost}

Table~\ref{tab:timing} presents measured latencies averaged over 20 inference cycles. The firmware reflex is approximately 40 times faster than intent classification, justifying separate firmware-level obstacle handling over routing everything through the cloud path. The end-to-end latency for a complete voice-to-motion cycle (wake word detection through motor actuation) averages 1.85 seconds, dominated by the Groq intent classification call. During visual search, each capture-describe-decide iteration takes approximately 2.5 seconds, meaning a 20-step search budget corresponds to roughly 50 seconds of wall-clock time.

\begin{table}[t]
\caption{End-to-end latencies ($n{=}20$ cycles, local Wi-Fi).}
\label{tab:timing}
\centering
\renewcommand{\arraystretch}{1.05}
\begin{tabularx}{\columnwidth}{@{}YCC@{}}
\toprule
\textbf{Stage} & \textbf{Mean $\pm$ SD} & \textbf{Range} \\
\midrule
Wake word detection & $62 \pm 18$\,ms & 38--95\,ms \\
Intent classification & $1.72 \pm 0.41$\,s & 1.0--2.5\,s \\
Plan generation (6 steps) & $2.89 \pm 0.53$\,s & 2.0--4.0\,s \\
VLM scene description & $2.31 \pm 0.58$\,s & 1.5--3.5\,s \\
Camera capture + encode & $142 \pm 26$\,ms & 98--195\,ms \\
ESP32 JSON parse & $2.1 \pm 0.8$\,ms & 1.2--4.3\,ms \\
Firmware reflex stop & $47 \pm 21$\,ms & 18--92\,ms \\
\bottomrule
\end{tabularx}
\end{table}

\begin{table}[t]
\caption{Bill of materials (2025 retail, USD).}
\label{tab:bom}
\centering
\renewcommand{\arraystretch}{1.05}
\begin{tabularx}{\columnwidth}{@{}YR@{}}
\toprule
\textbf{Component} & \textbf{Cost} \\
\midrule
Raspberry Pi 4 (4\,GB) & \$35 \\
ESP32 DevKit             & \$4 \\
Pi Camera v2.1           & \$10 \\
Motor driver + sensors   & \$5 \\
Display, mic, speaker    & \$10 \\
Chassis, motors, battery & \$13 \\
\midrule
\textbf{Total}           & \textbf{$<$ \$77} \\
\bottomrule
\end{tabularx}
\end{table}

% ====================================================================
\section{Discussion}
\label{sec:discussion}
% ====================================================================

The three-layer structure handles failure cases that no single layer could address alone. A validated command may become unsafe if the environment changes between validation and execution; for instance, a ``forward'' command issued when the path is clear becomes dangerous if an obstacle appears mid-execution. The firmware reflex covers this gap, providing continuous protection without re-querying the language model.

The body-context assembler proved essential for grounding the model in physical constraints. Without it, the LLM occasionally generated actions outside the motor vocabulary or requested speeds exceeding the PWM range. Including live sensor readings in the prompt also reduced the frequency of forward commands when ultrasonic values indicated narrow clearance, though this deliberative avoidance operates on a much slower timescale than the firmware reflex.

The episodic deduplication memory addressed a subtle failure mode during visual search. Without it, the robot frequently oscillated between two visually similar locations, consuming all 20 search steps without progressing. The adaptive threshold mechanism ($\tau$ reduced from 0.7 to 0.5 after five skipped frames) balances false positives against the need to escape repetitive loops.

The ablation results (Table~\ref{tab:ablation}) confirm that deliberation and reflex address fundamentally different failure classes on different timescales. Removing deliberative grounding reintroduces planning errors; removing the reflex reintroduces physical safety violations. Neither layer is redundant. The 42\% structural failure rate in raw model outputs underscores why a permissive pass-through approach to LLM-generated robot commands is unsafe regardless of prompt quality.

\subsection{Limitations and Future Work}

Three ultrasonic sensors leave angular blind spots between the 30-degree cones, meaning objects approaching from the side at shallow angles may not trigger the reflex until dangerously close. There is no manipulation or SLAM capability, so the robot cannot open doors or build persistent maps across sessions. All evaluation was conducted in a single room with small samples ($n{=}10$ per condition), limiting statistical power and generalisability to other environments. Cloud dependency introduces both latency variability and ongoing API cost; a single extended session of 50 inference calls costs approximately \$0.02 at current Groq pricing but remains unavailable without internet connectivity.

Future work targets an on-device Gemma-class model running quantised inference on the Pi to eliminate cloud dependency entirely. A depth camera would replace the ultrasonic sensors for denser 2D obstacle mapping. Wheel odometry combined with visual place recognition would enable metric mapping and multi-room navigation. Finally, a larger evaluation campaign across diverse indoor environments with hardware-in-the-loop logged benchmarks would strengthen the statistical evidence for each architectural claim.

% ====================================================================
\section{Conclusion}
\label{sec:conclusion}
% ====================================================================

This paper presented KANDA, a multimodal embodied robot agent demonstrating how explicit safety architecture makes cloud-based LLM reasoning viable for physical robot control on hardware costing under eighty dollars. The deliberative--critic--reflex decomposition provides safety at three timescales: the prompt grounds the model in physical reality before inference, the validator ensures correctness before transmission, and the firmware reflex provides millisecond-scale obstacle protection regardless of network conditions.

On the evaluation suite, the system achieves a macro-averaged intent F1 of 0.94 across 60 voice utterances, successfully locates target objects in 8 of 10 visual search trials, and terminates safely under all eight injected fault scenarios. The ablation study confirms that prompt grounding, episodic search memory, syntactic validation, and the firmware reflex each address non-overlapping failure classes, making all four components necessary. These results suggest that the barrier to building safe, multimodal embodied agents is primarily architectural rather than computational, and that careful layering of deterministic safety mechanisms around probabilistic language models can yield reliable physical behaviour even on inexpensive hardware.

% ====================================================================
\section*{Acknowledgment}
% ====================================================================

I thank the Department of Information Science and Engineering, RV College of Engineering, Bengaluru, for laboratory support and project guidance.

% ====================================================================
\begin{thebibliography}{00}

\bibitem{ahn2022saycan}
M. Ahn et al.,
``Do As I Can, Not As I Say: Grounding Language in Robotic Affordances,''
in \textit{Proc. Conf. Robot Learning (CoRL)}, 2022.

\bibitem{driess2023palme}
D. Driess et al.,
``PaLM-E: An Embodied Multimodal Language Model,''
in \textit{Proc. 40th Int. Conf. Machine Learning (ICML)}, 2023.

\bibitem{brohan2023rt2}
A. Brohan et al.,
``RT-2: Vision-Language-Action Models Transfer Web Knowledge to
Robotic Control,'' \textit{arXiv:2307.15818}, Jul.\ 2023.

\bibitem{brohan2022rt1}
A. Brohan et al.,
``RT-1: Robotics Transformer for Real-World Control at Scale,''
in \textit{Proc. RSS}, 2023. [arXiv:2212.06817]

\bibitem{vemprala2024chatgpt}
S. Vemprala, R. Bonatti, A. Bucker, and A. Kapoor,
``ChatGPT for Robotics: Design Principles and Model Abilities,''
\textit{IEEE Access}, vol.~12, pp.~1--20, 2024.

\bibitem{liang2023code}
J. Liang et al.,
``Code as Policies: Language Model Programs for Embodied Control,''
in \textit{Proc. IEEE ICRA}, 2023.

\bibitem{singh2023progprompt}
I. Singh et al.,
``ProgPrompt: Program Generation for Situated Robot Task Planning,''
in \textit{Proc. IEEE ICRA}, 2023.

\bibitem{huang2023grounded}
W. Huang et al.,
``Grounded Decoding: Guiding Text Generation with Grounded Models for
Robot Control,'' in \textit{Proc. NeurIPS}, 2023.

\bibitem{huang2022zeroshot}
W. Huang, P. Abbeel, D. Pathak, and I. Mordatch,
``Language Models as Zero-Shot Planners,''
in \textit{Proc. ICML}, 2022. [arXiv:2201.07207]

\bibitem{huang2022innermonologue}
W. Huang et al.,
``Inner Monologue: Embodied Reasoning Through Planning with LLMs,''
in \textit{Proc. CoRL}, 2022. [arXiv:2207.05608]

\bibitem{yao2023react}
S. Yao et al.,
``ReAct: Synergizing Reasoning and Acting in Language Models,''
in \textit{Proc. ICLR}, 2023. [arXiv:2210.03629]

\bibitem{zeng2023socratic}
A. Zeng et al.,
``Socratic Models: Composing Zero-Shot Multimodal Reasoning with Language,''
in \textit{Proc. ICLR}, 2023.

\bibitem{wei2022cot}
J. Wei et al.,
``Chain-of-Thought Prompting Elicits Reasoning in Large Language Models,''
in \textit{Proc. NeurIPS}, vol.~35, 2022.

\bibitem{amodei2016safety}
D. Amodei et al.,
``Concrete Problems in AI Safety,'' \textit{arXiv:1606.06565}, 2016.

\bibitem{brooks1986robust}
R. A. Brooks,
``A Robust Layered Control System for a Mobile Robot,''
\textit{IEEE J. Robotics Autom.}, vol.~2, no.~1, pp.~14--23, 1986.

\bibitem{fox1997dwa}
D. Fox, W. Burgard, and S. Thrun,
``The Dynamic Window Approach to Collision Avoidance,''
\textit{IEEE Robotics Autom. Mag.}, vol.~4, no.~1, pp.~23--33, 1997.

\bibitem{bonomi2012fog}
F. Bonomi, R. Milito, J. Zhu, and S. Addepalli,
``Fog Computing and its Role in the Internet of Things,''
in \textit{Proc. 1st ACM Workshop Mobile Cloud Computing}, pp.~13--16, 2012.

\bibitem{shi2016edge}
W. Shi, J. Cao, Q. Zhang, Y. Li, and L. Xu,
``Edge Computing: Vision and Challenges,''
\textit{IEEE Internet Things J.}, vol.~3, no.~5, pp.~637--646, 2016.

\bibitem{ratcliff1988}
J. W. Ratcliff and D. Metzener,
``Pattern Matching: The Gestalt Approach,''
\textit{Dr. Dobb's Journal}, Jul.\ 1988.

\bibitem{openwakeword2024}
D. Kamminga,
``openWakeWord: Open-Source Audio Wake Word Detection,''
GitHub, 2024. [Online]. Available: https://github.com/dscripka/openWakeWord

\end{thebibliography}

\end{document}
