darshacharya/KANDA/7. PPT for Review-I (3).pptx

## MTech in Information Technology Review-1 Major Project (MIT422P) A Multimodal Embodied Robot Agent Powered by LLMs with Hardware Aware Action Generation

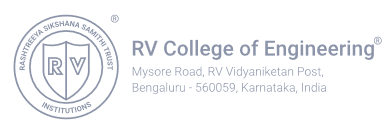
[picture p26: figure]

SUDARSHAN T S
1RV24SIT14
Prof. Sushmitha N
Assistant Professor
ISE
RVCE

## Relevance of Topic to IT

- This project applies core IT domains AI, Cloud Computing, and IoT to build an intelligent robot that perceives, reasons, and acts in a real physical environment.
- It demonstrates practical integration of Large Language Models with embedded hardware, addressing real-world challenges of deploying cloud AI on resource-constrained devices.
- The safety layer design reflects software engineering principles of fault tolerance and reliability, extending IT practices into autonomous physical systems.

## Slide 3

Literature Survey

Sl. No. | Paper Name | Author, Year | What It Does | Gap
1 | Smart Farming Robot for Detecting Environmental Conditions in a Greenhouse | Benos et al., 2023 | Mobile robot collects temp, humidity, CO₂ data | No visual inspection or control actions
2 | IoT Based Smart Greenhouse Framework and Control Strategies | Farooq et al., 2023 | IoT monitoring with rule-based automation | No AI reasoning or vision-based decisions
3 | Deep Learning CV Techniques for Smart Greenhouse (Review) | Akbar et al., 2024 | Reviews CNN, YOLO, transformer models | No robot integration or actuation
4 | Smart Greenhouse Design & Control (Systematic Review) | Ghiasi et al., 2023 | Covers MPC, RL, fuzzy control methods | No visual plant feedback in control
5 | LLMs & VLMs for Plant Stress Phenotyping | Zhu et al., 2024 | Uses AI models for plant stress detection | No link to physical control systems

## Slide 4

Problem Formulation

- Current greenhouse automation systems rely on fixed sensor thresholds to control temperature, humidity, and irrigation — they react to numbers but cannot observe or understand the actual condition of plants. Simultaneously, plant disease detection systems using AI can analyse images but produce only text reports with no connection to physical environment control. No existing low-cost system integrates visual plant inspection, AI-based reasoning, and closed-loop environment actuation into a single autonomous agent.
- This project addresses the question: can a mobile robot using a multimodal Large Language Model as its reasoning engine inspect plants visually, interpret environmental sensor data, and make safe, context-aware decisions to control greenhouse conditions — replacing rigid threshold logic with intelligent, observation-driven automation?

## Slide 5

Project Objectives and Scope

Objectives
- To design a hardware description prompt that communicates the robot's available sensors and actuators to an LLM as structured natural language context.
- To build a speech transcription pipeline using OpenAI Whisper that converts microphone input to text for submission to the LLM.
- To integrate a camera capture module that encodes visual frames and includes them in the multimodal LLM API request.
- To implement a motor actuation layer on Raspberry Pi that executes movement commands derived from the parsed LLM JSON response.
- To integrate a text-to-speech module that enables the robot to speak the verbal response returned by the LLM. Use similar to these
Scope
- Indoor greenhouse or small controlled plant setup only.
- Controls temperature, humidity, and irrigation — soil and pH monitoring not included.
- General plant stress observation — not species-level disease diagnosis.
- Safety layer enforces hard limits on all actuator commands without exception.
- Prototype scale — results are indicative, not production-ready claims.

## Slide 6

References

[1] Farooq, M. S., Javid, R., Riaz, S., & Atal, Z. — "IoT Based Smart Greenhouse Framework and Control Strategies for Sustainable Agriculture" — IEEE Access, Vol. 10, 2022.
[2] Benos, L., Tagarakis, A. C., & Bochtis, D. — "Smart Farming Robot for Detecting Environmental Conditions in a Greenhouse" — IEEE Sensors Journal, 2023.
[3] Zhao, X., et al. — "Implementation of Large Language Models and Agricultural Knowledge Graphs for Efficient Plant Disease Detection" — Agriculture, MDPI, Vol. 14, No. 8, 2024.
[4] Yang, X., et al. — "PLLaMa: An Open-Source Large Language Model for Plant Science" — arXiv:2401.01600, 2024.
[5] Zhu, H., et al. — "Potato Disease Detection and Prevention Using Multimodal AI and Large Language Model" — Computers and Electronics in Agriculture, Elsevier, Vol. 229, 2025.
[6] Stella, F., Della Santina, C., & Hughes, J. — "How Can LLMs Transform the Robotic Design Process?" — Nature Machine Intelligence, Vol. 5, 2023, pp. 561–564.
[7] Driess, D., et al. — "PaLM-E: An Embodied Multimodal Language Model" — Proceedings of ICML, Vol. 202, PMLR, 2023, pp. 8469–8488.
[8] Wake, N., et al. — "GPT-4V(ision) for Robotics: Multimodal Task Planning from Human Demonstration" — IEEE Robotics and Automation Letters, Vol. 9, No. 11, 2024, pp. 10567–10574.
[9] Shen, Y., et al. — "Large Language Models and Foundation Models in Smart Agriculture: Basics, Opportunities, and Challenges" — arXiv:2308.06668, 2024.
[10] Zhang, W., et al. — "Embodied Large Language Models Enable Robots to Complete Complex Tasks in Unpredictable Environments" — Nature Machine Intelligence, 2025.
