darshacharya/KANDA/presentation/kanda_review1.pptx

KANDA

A Multimodal Embodied Robot Agent

Powered by Large Language Models

Review I · Phase 2: Embodiment Layer

Hardware-Aware Autonomous Control System

PHASE 2 ✅

## Slide 2

Agenda

Review I · Kanda Robot Project

01

Introduction

02

Conceptual Understanding

03

Revisiting Objectives

04

05

Tool / Technique Selection & Justification

06

Solution Design Quality

Innovation & Problem-Solving

07

Partial Implementation

08

References

## Slide 3

Introduction

What is Kanda?

Kanda is a hardware-grounded robotic agent designed to evolve from a rule-based autonomous controller into a fully LLM-driven embodied AI system — integrating physical sensing, motor control, and natural language reasoning.

Problem Gap

✗ Existing robots are purely rule-based

✗ No integration of AI reasoning with physical hardware

✗ Limited adaptability to novel environments

✗ Multimodal input (vision/audio) largely absent

Proposed Solution

✓ Embodied robot with full sense–decide–act loop

✓ LLM as reasoning brain (Raspberry Pi bridge)

✓ Multimodal inputs: ultrasonic, camera, microphone

✓ Hardware-aware action generation via structured JSON

✓ Closed-loop feedback with real-time OLED display

## Slide 4

Conceptual Understanding

Embodied AI · Reactive vs Deliberative Agents

Embodied AI

• Intelligence that exists within a physical body

• Perception → Action loop is central

• Grounded in real-world sensor feedback

• Contrast: disembodied LLMs act on text only

Reactive Agent
(Current)

• Responds directly to sensor inputs

• No internal world model

• Fast, deterministic, hardware-safe

• Limited — cannot generalize to new tasks

Deliberative Agent
(Target)

• Builds context before acting

• Uses LLM for reasoning & planning

• Can handle open-ended instructions

• Slower but far more capable

## Slide 5

Revisiting Objectives

Original Goals vs Current Status

1

Objective

Build a stable hardware platform

Implementation Detail

Design stable power + sensor + motor system

Status

✅ Done

2

Real-time obstacle detection

3× HC-SR04 sensors with voltage dividers

✅ Done

3

4

Autonomous navigation logic

Real-time visual feedback

Sense→Decide→Act loop with smooth steering

SSD1306 OLED showing distances + decisions

✅ Done

✅ Done

5

Clean, conflict-free pin mapping

Avoided strapping/UART/unstable GPIO pins

✅ Done

6

Integrate LLM reasoning layer

Raspberry Pi bridge + LLM API pipeline

⏳ Planned

7

8

Multimodal input (camera, mic)

Hardware-aware JSON action generation

Camera + microphone module integration

Structured command protocol: Pi → ESP32

⏳ Planned

⏳ Planned

9

Closed-loop LLM feedback

Sensor telemetry fed back to LLM context

⏳ Planned

## Slide 6

Tool / Technique Selection & Justification

Hardware + Software stack decisions

Dual-core, built-in WiFi/BT, 3.3V, abundant GPIOs, ledc PWM API

ESP32

Microcontroller

Efficient H-bridge, 1.2A/ch, STBY pin, direction + PWM control

TB6612FNG

Motor Driver

Low cost, 2–400cm range; 1kΩ+1kΩ divider for 5V→2.5V ECHO

I2C (2 pins), 128×64, real-time decision feedback

HC-SR04 ×3

Ultrasonic Sensor

Stable 5V for ESP32; motors run on direct battery to avoid surge

SSD1306 OLED

Buck Converter

Display

Power Regulation

Full Linux OS, runs Python, calls LLM API, UART to ESP32

Raspberry Pi

AI Compute Bridge

Multimodal capability, function calling for structured JSON output

GPT-4 / Gemini

LLM Reasoning

Type-safe, validatable, hardware-safe action specification

JSON Protocol

Command Interface

## Slide 7

Solution Design — High-Level Architecture (HLD)

Full system view: completed (green) · planned (gray)

⚙️ Phase 2 — Embodiment Layer ✅

HC-SR04 (×3)

Front · Left · Right ultrasonic

ESP32 DevKit

Central microcontroller

TB6612FNG

Dual motor driver

SSD1306 OLED

I2C real-time display

LiPo + BMS + Buck

Stable power architecture

Left + Right Motor

Physical locomotion

🧠 Phase 3 — Intelligence Layer ⏳

Camera Module

Visual perception input

Microphone

Audio / speech input

Raspberry Pi

AI compute bridge (brain)

LLM API

GPT-4 / Gemini reasoning

Safety Validator

Command verification layer

Speaker (TTS)

Audio output / feedback

UART

## Slide 8

Solution Design — Low-Level Design (LLD)

Pin mapping · Power architecture · Signal conditioning

GPIO

GPIO 5

ESP32 Pin Mapping

Function

TRIG_F (Front HC-SR04)

Power Architecture

LiPo Battery 7.4V

GPIO 34

ECHO_F [input-only, 2.5V divider]

BMS (protection)

GPIO 13

GPIO 35

TRIG_L (Left HC-SR04)

ECHO_L [input-only, 2.5V divider]

Main Switch

GPIO 4

GPIO 32

TRIG_R (Right HC-SR04)

ECHO_R [2.5V divider]

Buck Converter → 5V

TB6612FNG VM

GPIO 18

GPIO 19

AIN1 — Motor A dir

AIN2 — Motor A dir

ESP32 VIN

Motors (L+R)

Raspberry Pi ⏳

GPIO 23

GPIO 26

PWMA — Motor A speed

BIN1 — Motor B dir

★ All grounds tied together (common GND)

★ Capacitors across motor rails — suppress voltage spikes

GPIO 27

GPIO 14

BIN2 — Motor B dir

PWMB — Motor B speed

★ Motors NOT powered through buck (current surge protection)

GPIO 21

GPIO 22

SDA — OLED I2C

SCL — OLED I2C

GPIO 1/3

UART TX/RX → Raspberry Pi

## Slide 9

Flow Diagram — Sense → Decide → Act

Current: rule-based (green) · Planned: LLM-driven (gray)

Current Implementation ✅

⚡ Power On & Init

Planned: LLM-Driven ⏳

Camera + Mic + Sensor Input

Read F / L / R Distances

Build Multimodal Context

Front < 20 cm?

LLM API Call (Raspberry Pi)

Stop Motors · 200ms

Parse JSON Command

Left > Right? → Turn L / R

Phase 3

Safety Validation

Left < 15 cm? → Slight Right

Serial → ESP32

Right < 15 cm? → Slight Left

Execute Motor Command

FORWARD at speedVal

Sensor telemetry → Pi (loop)

Update OLED + Serial log

Delay 100ms → loop

## Slide 10

Use Case Diagram

Actor → System interactions · completed (green) · planned (gray)

Kanda Robot System

Flash Firmware to ESP32

Monitor via Serial + OLED

Give Voice / Text Command

Camera Scene Understanding

Tune Speed / Threshold Params

LLM Reasoning & Decision

👤 User /
Engineer

Autonomous Obstacle Avoidance

Natural Language Action

Real-time Sensor Display

Safety Override / Validation

🤖 LLM Service
(API)

🌍 Environment
(Physical)

✅ Completed

⏳ Planned

## Slide 11

Innovation & Problem-Solving

Engineering decisions that made the system work

Hardware-First AI Foundation

• Built full embodiment layer before AI to ensure stable execution substrate

• Most academic projects bolt hardware onto AI — we invert this correctly

• Result: deterministic, safe motor control regardless of AI state

Voltage Divider Improvisation

• HC-SR04 ECHO outputs 5V — unsafe for ESP32 3.3V GPIO

• No 2kΩ resistors available → used 1kΩ + 1kΩ (same ratio, same result)

• Demonstrates engineering principle: workable + safe > perfect

ESP32 Core v3 API Migration

• ledcSetup() deprecated in Arduino core v3 — caused compile errors

• Migrated to new ledcAttach(pin, freq, bits) single-call API

• Proactively future-proofed against further deprecation

Dual-Layer Architecture (Body/Brain)

• ESP32 = Body: fast, deterministic hardware execution

• Raspberry Pi = Brain: LLM reasoning, context, planning

• Separation allows independent testing and safe fallback

## Slide 12

Partial Implementation — Phase 2 Complete

What is built · tested · and working now

✅ Completed & Working

Power Architecture

Battery → BMS → Buck → ESP32 (motors direct)

3× HC-SR04 Sensors

Voltage dividers on ECHO · GPIO34/35/32

TB6612FNG Motor Driver

AIN/BIN direction + PWMA/PWMB speed control

SSD1306 OLED

I2C on GPIO21/22 · real-time sensor + action display

Obstacle Avoidance Logic

Front threshold · side steering · smooth turning

Pin Mapping

Conflict-free · no strapping/UART/unstable pins

ESP32 Core v3 Firmware

ledcAttach() API · serial debug output

⏳ Pending — Phase 3

Raspberry Pi Integration

UART bridge ESP32↔Pi · JSON command protocol

Camera Module

Video frames → Pi → LLM context

Microphone

Audio input · speech-to-text pipeline

LLM API Pipeline

Prompt engineering · GPT-4/Gemini integration

Safety Validator

Command range checks before motor execution

Speaker / TTS

Audio feedback from robot

Closed-Loop Telemetry

Sensor data fed back into LLM context

## Slide 13

References

[1] Espressif Systems. (2024). ESP32 Technical Reference Manual. https://docs.espressif.com

Hardware datasheet for ESP32 microcontroller

[2] Toshiba. (2020). TB6612FNG Dual DC Motor Driver Datasheet.

Motor driver component specification

[3] JSR. HC-SR04 Ultrasonic Module User Guide.

Ultrasonic sensor operational parameters

[4] Solomon Systech. SSD1306 OLED Datasheet.

128×64 OLED display I2C communication protocol

[5] Brown, T., et al. (2020). Language Models are Few-Shot Learners. NeurIPS.

Foundation paper on GPT-3 / LLM capabilities

[6] Ahn, M., et al. (2022). Do As I Can, Not As I Say: Grounding Language in Robotic Affordances. arXiv:2204.01691.

SayCan — embodied AI with LLM reasoning

[7] Brohan, A., et al. (2023). RT-2: Vision-Language-Action Models Transfer Web Knowledge to Robotic Control. arXiv:2307.15818.

Multimodal LLM-to-robot action transfer

[8] Peng, X., et al. (2023). EmbodiedGPT: Vision-Language Pre-Training via Embodied Chain of Thought. arXiv:2305.15021.

Chain-of-thought reasoning for embodied agents

[9] Arduino. (2024). ESP32 Arduino Core v3 Migration Guide. https://docs.arduino.cc

ledcAttach API changes from core v2 to v3

## Slide 14

Thank You

Kanda · A Multimodal Embodied Robot Agent

Phase 2 Complete · Foundation ready for LLM Integration

Hardware Platform ✅

Obstacle Avoidance ✅

OLED Feedback ✅

LLM Integration ⏳

Multimodal Input ⏳
