darshacharya/KANDA/major project report v1.docx

ABSTRACT

The project titled AI-Based Framework for Geo-Ecosystem Monitoring Using Time-Series Satellite Images was developed to monitor environmental and land surface changes using multi-temporal satellite data and artificial intelligence techniques. Geo-ecosystem monitoring became increasingly important because rapid urban growth, vegetation loss, and land transformation affected ecological balance and long-term planning. In this work, Sentinel-2 satellite images of Bangalore Urban for the years 2018, 2020, 2023, and 2025 were analyzed to study changes in vegetation, urban area, water, and barren land. The framework was based on Google Earth Engine for satellite data collection and cloud masking, and it used machine learning and deep learning models for classification and change analysis.

The proposed system followed a sequence of image acquisition, preprocessing, patch extraction, model training, prediction, and temporal analysis. Random Forest, U-Net, DeepLabV3, and SegFormer models were evaluated for geo-ecosystem classification, and the results showed that U-Net performed the best among the tested models. The implementation was carried out in Google Colab using Python, Rasterio, NumPy, Scikit-learn, and PyTorch. The study assumed four major classes of interest and used patch-based learning to handle large satellite images efficiently. Performance was measured using Accuracy, Cohen’s Kappa, Mean Intersection over Union (Mean IoU), and class-wise IoU values.

The results showed that the developed framework was effective for monitoring geo-ecosystem changes over time. Proposed U-Net achieved the highest performance with 95.99 percent accuracy, 0.9159 Kappa, and 0.7497 Mean IoU, while Random Forest achieved 85.80 percent accuracy and lower segmentation quality. The time-series analysis also showed a continuous increase in urban area and a decline in vegetation from 2018 to 2025, confirming visible environmental change in Bangalore Urban. The project demonstrated that artificial intelligence and satellite imagery together can provide an accurate and scalable solution for geo-ecosystem monitoring.

CHAPTER 1

INTRODUCTION

1.1 Overview of Project Topic

The project titled AI-Based Framework for Geo-Ecosystem Monitoring Using Time-Series Satellite Images was carried out to study how artificial intelligence can support environmental monitoring through repeated satellite observations. In rapidly changing urban regions, the condition of land surfaces does not remain fixed; vegetation cover, built-up area, water spread, and exposed land often shift over time as development and ecological pressure increase. Because of this, monitoring the same region across multiple years has become more useful than relying on isolated observations taken at only one time.

Satellite remote sensing offered an effective way to observe these changes because it provided broad coverage, repeated acquisition, and consistent visual records of the Earth’s surface. Instead of depending only on manual surveys, which are slow and limited in scale, image-based analysis made it possible to examine larger regions in a more systematic way. When artificial intelligence models were applied to such imagery, the monitoring process became more suitable for extracting patterns, identifying surface categories, and supporting long-term ecological interpretation.

This work was centered on Bangalore Urban, a region that has experienced visible transformation over the years due to expansion of built-up zones and pressure on natural land cover. The project therefore aimed to create a practical framework that could use multi-year satellite images to track geo-ecosystem variation in a structured and measurable form. Rather than treating the study as only a mapping task, the work approached it as an integrated monitoring problem in which temporal observations could reveal how the landscape evolved over time.

The topic of this project lies at the intersection of remote sensing, artificial intelligence, and environmental observation. Its central idea was to build a framework capable of interpreting satellite images collected at different points in time and converting them into meaningful information about ecosystem condition. In this context, geo-ecosystem monitoring referred to observing the spatial distribution and temporal variation of important surface elements that reflect the ecological and developmental state of a region.

Time-series imagery was important to this topic because environmental change is gradual and often becomes visible only when observations from multiple years are compared. A single image may show the state of an area on one date, but a sequence of images can indicate persistent increase, decline, or transformation. This made time-series satellite analysis relevant for identifying long-term trends instead of one-time conditions.

Artificial intelligence was included in the project because manually interpreting large satellite datasets is difficult, especially when the study area is wide and the image resolution is high. Learning-based models can process patterns in pixel data more efficiently and can support detailed classification of land categories. The project therefore focused on designing a framework in which multi-temporal imagery and AI-based analysis worked together to support geo-ecosystem assessment.

1.1.1 Global Scenario

Across the world, satellite-based environmental monitoring has become more significant as countries face rapid urban growth, ecological degradation, and increasing demand for sustainable planning. Governments and research organizations now rely more heavily on Earth observation data to understand how land systems are changing and to support policy decisions related to development, conservation, and climate resilience. This global shift has increased the use of time-series imagery because repeated observations reveal the direction and pace of change more effectively than static snapshots.

At the same time, artificial intelligence has strengthened the value of remote sensing by enabling automated interpretation of large image collections. Deep learning and semantic segmentation methods have recently gained attention because they help produce fine-grained, pixel-level outputs from complex satellite scenes. These advances have opened new possibilities for practical environmental monitoring systems that can operate with better speed and consistency than traditional approaches.

The present project fits within this broader global movement by applying similar ideas to an urban Indian context. It reflects the growing need for localized monitoring frameworks that use modern AI techniques while remaining adaptable to the specific environmental pressures of a chosen study region. In that sense, the project contributes to an internationally relevant area of work while staying grounded in a real geographic problem.

1.1.2 Societal Relevance

The social importance of this project comes from the fact that changes in land surface patterns influence the quality, sustainability, and livability of urban environments. Reduction in vegetation, expansion of built-up areas, and stress on natural resources can affect ecological balance, local climate, water retention, and public well-being. Monitoring such changes is therefore not only a technical task but also a socially relevant activity connected to planning and responsible resource use.

A framework that can track these changes from satellite data can support planners, environmental analysts, and local authorities in understanding how a region is evolving. Reliable monitoring helps in identifying areas where green cover is shrinking, urban growth is accelerating, or surface conditions are changing in ways that may require intervention. By turning image data into interpretable outputs, such systems make environmental evidence more accessible for planning and public decision-making.

In a city-region like Bangalore Urban, where development pressure is high, this relevance becomes even stronger. A monitoring framework of this kind can serve as a useful reference for sustainable urban management because it helps reveal long-term spatial change in a measurable way. The project therefore had practical value beyond technical experimentation, since its outcomes can support awareness and planning in a rapidly transforming urban ecosystem.

1.1.3 Problem Area

Although satellite imagery is widely available, deriving reliable ecosystem information from it is not straightforward. Raw images may contain cloud contamination, large spatial dimensions, and complex surface patterns that make direct analysis difficult. In addition, some land categories may appear spectrally similar, which creates ambiguity during classification and reduces the quality of straightforward mapping methods.

Another challenge is that monitoring over time requires more than just classifying one image correctly. A useful framework must handle multi-year observations in a consistent way so that differences across time reflect real land change rather than processing noise or model instability. This makes the problem more demanding than ordinary image labeling, especially when the goal is to compare ecological conditions across several years in the same region.

The problem addressed by this project was therefore the development of a robust AI-based framework that could interpret time-series satellite images and generate dependable geo-ecosystem information for Bangalore Urban. The intention was not only to classify land categories, but also to build a system capable of supporting temporal monitoring in a meaningful and scalable manner. This formed the core problem area on which the rest of the project was based.

1.2 Specific Details of the Project Topic

This project dealt with the design of a monitoring framework that interpreted multi-year satellite imagery to study surface-level ecological change in an urban region. The topic was specific to geo-ecosystem observation, where the focus was not only on identifying land categories, but also on understanding how those categories shifted across time in a measurable way. In this work, the project was framed as a temporal monitoring task rather than a one-time image classification exercise.

The study area selected for the project was Bangalore Urban, and the analysis was restricted to that region so the framework could be tested on a clearly defined geographic boundary. The temporal span covered four different years—2018, 2020, 2023, and 2025—which allowed the project to observe change patterns over time instead of relying on a single-date satellite image. This made the project suitable for examining gradual transformation linked to urban growth and ecological variation.

The satellite source used in the project was Sentinel-2 imagery, from which five spectral bands were selected for analysis. These images were obtained and prepared through Google Earth Engine, and the corresponding labels were generated using a land-cover reference workflow before being exported for model development. To keep the problem well defined, the final classification task was limited to four classes: vegetation, urban, water, and barren land.

A key detail of the topic was that the project did not rely on a single model. Instead, it compared multiple learning approaches in order to identify the most effective method for this type of satellite-image interpretation. The models considered in the work included Random Forest, U-Net, DeepLabV3, and SegFormer, which represented both conventional machine learning and modern deep learning approaches. This comparison made the project more complete because it evaluated the topic from both performance and applicability perspectives.

Another important detail was the patch-based design of the framework. Since large satellite images are difficult to process directly, the data were divided into smaller fixed-size patches before training and testing. This supported manageable computation, improved model learning, and made the framework more practical for semantic segmentation and class-wise analysis. The topic therefore involved not just environmental monitoring, but also the design of a technically workable pipeline for handling large-scale geospatial image data.

The final scope of the topic included classification, evaluation, and interpretation of temporal change. It did not stop at producing predicted maps; it also measured class-wise area distribution and tracked how the selected categories varied from one year to another. In this sense, the project topic was specifically about building an end-to-end AI framework that could convert time-series satellite observations into structured geo-ecosystem information.

1.4 Problem Statement

Rapid urban growth has been altering the natural and built environment of many cities, making continuous geo-ecosystem monitoring increasingly necessary. In regions such as Bangalore Urban, changes in vegetation, built-up land, water spread, and open surfaces do not occur in isolation; they develop gradually and interact with one another over time. When such transformations are not monitored properly, it becomes difficult to understand the ecological impact of urban expansion or to support evidence-based planning. Satellite remote sensing offers repeated observations of the same area, but the availability of imagery alone does not automatically solve the problem of meaningful environmental interpretation.

The core problem was that existing approaches for land and ecosystem monitoring were often either too manual, too fragmented, or too limited to capture temporal change in a reliable and scalable way. Conventional surveys required significant time and effort, while isolated image analysis did not adequately represent how a region evolved across years. For effective geo-ecosystem assessment, there was a need for a framework that could analyze time-series satellite imagery systematically and identify major surface categories in a consistent manner. Without such a framework, monitoring remained descriptive rather than analytical, and long-term change patterns were difficult to quantify.

Therefore, the problem addressed in this project was the absence of an integrated artificial intelligence based system for monitoring geo-ecosystem change from time-series satellite images. The project aimed to address this need by developing a framework capable of processing multi-year satellite data, classifying important land categories, and supporting temporal analysis of environmental change in Bangalore Urban. In this way, the study responded to a practical monitoring problem by combining repeated satellite observations with automated image interpretation.

1.5 Objectives

The objectives of the proposed project were defined to guide the development of an artificial intelligence based framework for geo-ecosystem monitoring using time-series satellite images. They were formulated to reflect the major tasks carried out in the study and to maintain clarity in the scope of work.

- To acquire and prepare multi-temporal Sentinel-2 satellite images of Bangalore Urban for the selected study years and organize them for geo-ecosystem analysis.
- To develop an automated framework for classifying major geo-ecosystem categories, namely vegetation, urban area, water, and barren land, from satellite imagery.
- To implement and compare multiple machine learning and deep learning models, including Random Forest, U-Net, DeepLabV3, and SegFormer, in order to identify the most effective model for the given monitoring task.
- To analyze ecosystem transitions across multiple years in the study area
- To provide explanations for detected ecosystem changes using relevant environmental information.
- To develop a web-based interface for visualizing ecosystem classification results, detected changes, and system-generated explanations.

1.6 Scope of the Project

The scope of the present work was confined to the development of an AI-based framework for geo-ecosystem monitoring using time-series satellite images of Bangalore Urban. The study focused on analyzing temporal surface changes through a defined workflow that included satellite image collection, preprocessing, model-based classification, and change interpretation. In order to maintain clarity and feasibility, the project was limited to a selected urban study region, a fixed set of years, and a specific group of land-surface categories. A proper scope section should define what is included in the project and what falls outside its boundaries.

The project included the use of Sentinel-2 imagery for the years 2018, 2020, 2023, and 2025, with analysis restricted to four classes: vegetation, urban area, water, and barren land. It covered the preparation of image-label datasets, division of images into patches, implementation of classification models, and performance evaluation using standard metrics. The work also extended to temporal interpretation by examining how class distributions changed across the selected years in the Bangalore Urban region.

At the same time, the scope did not extend to all possible aspects of geo-ecosystem assessment. The project did not include field-based ecological sampling, multisensor fusion from radar or thermal datasets, real-time deployment, or large-scale generalization across multiple cities. It was also not intended to provide a complete environmental policy model; instead, it was designed as a technical framework for automated monitoring based on satellite imagery and artificial intelligence. Clearly stating inclusions and exclusions is a standard part of writing a good scope section.

Thus, the scope of the project remained centered on designing, implementing, and evaluating a region-specific time-series monitoring framework that could classify major geo-ecosystem components and reveal temporal land-surface changes. The study was therefore broad enough to demonstrate the usefulness of AI in satellite-image analysis, while still remaining limited enough to be completed as a focused academic project

1.7 Methodology

The methodology of the project was carried out in a systematic sequence to develop an AI-based framework for geo-ecosystem monitoring using time-series satellite images. The complete workflow was designed to move from data acquisition to final evaluation in a structured manner. Each step contributed to the preparation, classification, and analysis of satellite imagery for Bangalore Urban.

Step 1: Data acquisition

Sentinel-2 satellite images for the years 2018, 2020, 2023, and 2025 were collected for the selected study area, Bangalore Urban. The image selection was limited to the required region and time period so that temporal land-surface changes could be analyzed consistently.

Step 2: Preprocessing

The collected images were preprocessed to improve data quality. Cloud-contaminated pixels were removed, and median composite images were generated to reduce noise and obtain clearer observation layers. The images were then prepared with the corresponding labels required for supervised learning.

Step 3: Dataset preparation

The preprocessed satellite images were exported and converted into a format suitable for model training. Since satellite scenes are large and complex, they were divided into smaller image patches to make computation easier and to improve learning efficiency. The dataset was then organized into training, validation, and testing subsets.

Step 4: Model development

The classification stage was carried out using multiple models to compare performance. Random Forest was used as a baseline machine learning model, while U-Net, DeepLabV3, and SegFormer were used as deep learning-based semantic segmentation models. These models were trained to classify the satellite patches into four classes: vegetation, urban area, water, and barren land.

Step 5: Model evaluation

The trained models were evaluated using standard performance metrics. Accuracy, Cohen’s Kappa, and Mean Intersection over Union were used to measure classification quality and compare the models. Class-wise outputs were also analyzed to understand how well each land category was identified.

Step 6: Temporal analysis

After classification, the output maps were compared across the selected years to study changes in land cover over time. This allowed the project to identify trends such as vegetation loss, urban expansion, and variation in other geo-ecosystem classes.

1.8 Organization of Report

CHAPTER 2

THEORY AND CONCEPT OF PROJECT

2.1 Introduction to Geo-Ecosystem Monitoring

Geo-ecosystem monitoring refers to the observation and analysis of natural and human-influenced land surfaces in order to understand how environmental conditions change over time. It focuses on components such as vegetation, water bodies, built-up land, and barren surfaces, since these elements together reflect the ecological state of a region. In urban and semi-urban areas, such monitoring is especially important because land transformation often happens gradually and may not be visible without systematic analysis.

Traditional field-based monitoring methods can provide detailed local information, but they are usually time-consuming, costly, and difficult to repeat over large areas. For this reason, satellite remote sensing has become one of the most practical tools for geo-ecosystem studies. It allows repeated observation of the same geographic region at different times, making it possible to study land-use and land-cover change, seasonal variation, and long-term ecological trends.

In recent years, geo-ecosystem monitoring has increasingly been linked with artificial intelligence techniques because large satellite datasets are difficult to analyze manually. Machine learning and deep learning methods can process image patterns more efficiently and help classify land-surface features with higher consistency. This has made automated monitoring frameworks more useful for environmental assessment, urban planning, and sustainable resource management.

For this project, geo-ecosystem monitoring was applied to Bangalore Urban using time-series Sentinel-2 satellite images. The purpose was to study how major land categories changed across different years and to build a framework that could support automated, repeatable, and accurate analysis of temporal environmental change. This forms the conceptual base for the remaining sections of the chapter.

2.2 Remote Sensing Fundamentals

Remote sensing is the science of obtaining information about the Earth’s surface without direct physical contact. It works by capturing reflected or emitted energy from the land surface through sensors mounted on satellites or aircraft. In the context of environmental monitoring, remote sensing is valuable because it provides a wide-area view of land conditions and allows repeated observation over time.

Satellite remote sensing is especially useful for geo-ecosystem studies because it can record vegetation, water, soil, and built-up surfaces across large regions in a consistent manner. Each object on the Earth reflects electromagnetic energy differently, and these differences appear in the satellite image as variations in pixel values. By analyzing these variations, it becomes possible to distinguish one land-cover type from another.

A satellite image is formed using multiple spectral bands, and each band represents reflected energy within a specific wavelength range. These bands help in identifying surface characteristics that may not be visible in ordinary visual images. For example, vegetation often shows distinct reflectance behavior in the near-infrared region, while built-up areas and water bodies exhibit different spectral responses. This spectral variation is the basis for image interpretation and classification.

Remote sensing data also varies by spatial resolution, spectral resolution, and temporal resolution. Spatial resolution determines the level of detail visible in the image, spectral resolution defines the number of wavelength bands captured, and temporal resolution indicates how often the same region is observed. In this project, time-series analysis depended on temporal resolution because repeated observations were required to study land-surface changes across multiple years.

For geo-ecosystem monitoring, remote sensing provides an efficient way to detect urban expansion, vegetation loss, and changes in natural land cover. It reduces dependence on manual surveys and makes it possible to build automated monitoring systems using artificial intelligence. Therefore, remote sensing formed the core data source for the project and provided the foundation for all later processing and analysis.

2.3 Satellite Image Time Series

Satellite image time series refers to a sequence of images of the same geographic region captured at different points in time. Instead of analyzing a single image, this approach makes it possible to observe how land features change gradually over months or years. In geo-ecosystem monitoring, this is important because environmental change is often slow, cumulative, and spatially uneven.

The main advantage of time-series analysis is that it reveals temporal patterns that cannot be identified from one-date imagery alone. A single satellite image can show the current state of a region, but a sequence of images can indicate whether vegetation is decreasing, built-up area is expanding, or water bodies are changing. This makes time-series data particularly useful for studying urban growth and land transformation.

Time-series imagery also helps in separating seasonal variation from actual long-term change. Some land-cover changes may occur because of weather conditions or natural cycles, while others reflect permanent transformation due to development or ecological stress. By comparing images from multiple years, the project could focus on persistent change rather than short-term variation.

In this project, satellite image time series were used to analyze Bangalore Urban across selected years. The repeated observations made it possible to compare land-cover distribution over time and identify changes in vegetation, urban land, water, and barren surfaces. This formed the temporal basis for the classification and monitoring framework used in the study.

2.4 Deep Learning for Land-Cover Classification

Deep learning has become an important approach for land-cover classification because it can learn complex spatial patterns directly from satellite imagery. Unlike traditional methods that depend heavily on manually selected features, deep learning models extract useful representations automatically from the image data itself. This makes them especially suitable for remote sensing tasks where land classes may be visually similar and spatially mixed.

In land-cover mapping, the objective is to assign each pixel or image region to a meaningful category such as vegetation, urban land, water, or barren surface. Deep learning models are effective in this task because they can capture both local texture and broader contextual information. This is useful in satellite scenes, where the same class may appear in different shapes, sizes, and surrounding conditions.

Among deep learning approaches, convolutional neural networks are widely used because they are strong at processing image data. For semantic segmentation tasks, encoder-decoder architectures are particularly useful because they preserve spatial information while learning high-level features. Models such as U-Net and its variants are therefore well suited to land-cover classification, since they can produce pixel-level predictions instead of only assigning a single label to an entire image.

Deep learning also supports more reliable monitoring when the goal is to compare land-cover patterns across multiple years. Once trained, the model can be applied to images from different time periods and produce consistent classification outputs. This consistency is important for time-series geo-ecosystem analysis because changes in class distribution can then be interpreted as real surface transformation rather than inconsistent manual labeling.

In this project, deep learning provided the main technical basis for classifying satellite image patches into the selected geo-ecosystem classes. It supported automated interpretation of the imagery and made it possible to compare land-cover patterns over time with greater precision. For this reason, deep learning formed a central part of the conceptual foundation of the proposed monitoring framework.

2.5 Summary

This chapter presented the conceptual background needed for understanding the proposed project. It began with geo-ecosystem monitoring, which explained why repeated observation of land-surface change is important in urban environments. It then introduced remote sensing as the main data source for observing the Earth’s surface over large areas and across multiple time periods.

The chapter also explained the idea of satellite image time series and showed why multi-temporal imagery is more informative than a single-date image. It further discussed deep learning for land-cover classification, which provided the technical basis for automated interpretation of satellite imagery. Together, these concepts formed the theoretical foundation for the framework developed in the project.

CHAPTER 3

Software Requirement Specification

3.1 Overall Description

The proposed system, named EcoChangeNet, was developed as a web-based geo-ecosystem analysis and monitoring application for Bangalore Urban. The main purpose of the system was to provide an accessible platform through which a user could interact with spatial data, select a study region through a map interface, and obtain land-cover analysis, temporal change analysis, and future trend-oriented environmental insights. Unlike a standalone model execution workflow, the developed product was implemented as an integrated web application in which the analysis pipeline was connected to a user-facing interface. The homepage and navigation structure shown in the developed interface included modules such as Home, Map Analysis, Change Analysis, About, and Chatbot, reflecting the application-oriented nature of the final system.

The frontend of the system was developed using HyperText Markup Language (HTML) and Cascading Style Sheets (CSS), while the backend was implemented using FastAPI. The backend handled core analytical operations, including model execution, request processing, and generation of prediction results. In this architecture, the trained model resided on the server side and was not directly exposed to the client interface. This separation between interface and processing logic made the system more structured, easier to manage, and better suited for controlled interaction with the analysis engine.

A key feature of the application was the use of a Leaflet-based interactive map, which allowed the user to select a region for analysis. However, the operational scope of this interaction was intentionally restricted to Bangalore, since the underlying model was trained specifically on data from that region. As a result, the system combined interactivity with a controlled geographic boundary, ensuring that user inputs remained aligned with the trained capability of the model. This design decision improved the practical reliability of the results by preventing unsupported regional analysis beyond the training domain.

The system provided two major analytical modules. The first was Map Analysis, which was designed to estimate land-cover classes and their percentage distribution for the selected region. Through this module, the user could interpret the ecological composition of the selected area in terms of vegetation, urban area, water, and barren land. The second was Change Analysis, which focused on multi-temporal environmental assessment by comparing outputs across selected years. This module was intended to help the user observe how the geo-ecosystem had changed over time rather than viewing only a single-date land-cover snapshot.

In addition to current-state and temporal analysis, the application also included a simple future trend prediction component based on Linear Regression. This feature was designed to extend the monitoring capability of the platform by indicating possible future trajectories from previously observed temporal patterns. Although this prediction mechanism was relatively simple compared to deep learning-based classification, it contributed an additional analytical layer by linking historical change with estimated future trends. This made the web application more than a visualization tool; it functioned as a lightweight decision-support system for geo-ecosystem interpretation.

The product was therefore positioned as a domain-specific environmental analysis system rather than as a general-purpose mapping portal. It was built to support controlled geo-ecosystem monitoring for Bangalore Urban using a trained backend model, web-based interaction, and modular analytical pages.

From a software engineering perspective, the overall description of the system can therefore be understood through four tightly connected layers: the presentation layer built with HTML and CSS, the interaction layer supported through Leaflet map input and navigation, the application layer managed by FastAPI, and the analytical layer where the trained model performed prediction and result generation. These layers together formed a complete web-based product for geo-ecosystem analysis. Because the application was built around a real workflow, constrained study region, and model-backed backend, it satisfied the structure of a research-driven software product rather than a purely conceptual prototype.

3.1.1 Product Perspective

EcoChangeNet was developed as a web-based geo-ecosystem monitoring application that integrated spatial visualization, analytical processing, and result presentation into a single platform. The system was positioned as an interactive decision-support tool for land-cover assessment and temporal environmental change detection in Bangalore Urban. Its architecture separated the user interface from the analytical backend, thereby allowing users to access model outputs through a browser without direct interaction with the underlying computation layer. The product perspective therefore reflected a modular client-server design in which the frontend handled visualization and user interaction, while the backend executed the trained model and returned analysis results.

From a software engineering viewpoint, the system functioned as a domain-specific application rather than a general-purpose mapping platform. The interface was designed to guide the user through map-based selection and analytical navigation, while the backend remained responsible for processing the input region and generating predictions. This structure improved usability, maintainability, and deployment flexibility. Since the model had been trained exclusively on Bangalore data, the system was intentionally constrained to the same geographic domain to preserve output validity and avoid unsupported inference outside the training region.

3.1.2 Product Functions

The system provided several core functions that supported geo-ecosystem analysis. The primary function was map-based region selection, implemented using Leaflet, which enabled the user to interact with the spatial interface and choose the study area within Bangalore. Once the region was selected, the backend processed the request and generated analytical outputs corresponding to the trained model.

The second function was land-cover analysis, in which the system estimated the percentage distribution of major land-cover classes such as vegetation, urban area, water, and barren land. This function helped the user understand the ecological composition of the selected region in quantitative terms. The third function was change analysis, which compared multi-temporal outputs to detect land-cover transitions over different years. This feature supported temporal monitoring and made it possible to identify patterns of urban expansion, vegetation loss, or other landscape changes.

A further function was future trend estimation using a simple Linear Regression-based prediction approach. This function projected likely future changes by analyzing previously observed temporal patterns. In addition, the application included separate navigation modules such as Home, Map Analysis, Change Analysis, and About, which organized the user workflow and improved accessibility. Overall, the system functioned as an integrated platform for land-cover interpretation, change detection, and trend-oriented environmental analysis.

3.1.3 Constraints

The first major constraint of the system was its geographic limitation. The model had been trained only on Bangalore data, and therefore the application was restricted to Bangalore Urban for valid analysis. Although the Leaflet interface supported region selection, analysis outside the trained area was not considered reliable. This constraint was necessary to preserve model consistency and to avoid misleading predictions.

The second constraint was related to model dependence. Since the analytical results were generated through a backend-trained model, the quality of the outputs depended heavily on the training data, preprocessing strategy, and model generalization capability. Any bias or incompleteness in the training set could affect classification accuracy and change detection reliability. The third constraint was the simplicity of future prediction, because the project used Linear Regression rather than a more advanced forecasting model. As a result, the prediction component provided trend-based estimation rather than highly complex temporal forecasting.

Another practical constraint was the web deployment structure. Because the system used a browser-based frontend and backend API communication, the application depended on proper network interaction between client and server. Performance was therefore influenced by backend response time, server availability, and the smooth transfer of map-based requests. In addition, the current scope did not include RAG-based chatbot functionality, since that component was still under development and planned for later integration.

3.2 Specific Requirements

This section defined the detailed requirements of the EcoChangeNet system, including functional behavior, performance expectations, software dependencies, hardware needs, and design limitations. The requirements were written to match the implemented web-based architecture and the constrained Bangalore-specific analysis scope.

3.2.1 Functional Requirements

The system shall provide a browser-based interface for geo-ecosystem analysis. The user shall be able to open the homepage, navigate through the available modules, and initiate analysis from the map-driven interface. The application shall allow the user to select the study region through an interactive Leaflet map, subject to the Bangalore-only training domain of the model.

The system shall perform land-cover classification for the selected region and display the percentage distribution of major classes. The application shall support multi-temporal change analysis for comparing outputs across different years and identifying land-cover transitions. The system shall also provide trend-based future prediction using a Linear Regression approach. The backend shall process analysis requests through FastAPI and return results to the frontend for visualization.

3.2.2 Performance Requirements

The system shall generate analysis outputs within a reasonable response time after the user submits a request. The backend shall be able to process map-based input and return results without significant delay during normal usage. The interface shall remain responsive while handling navigation, map interaction, and result display.

The model inference process shall be sufficiently efficient to support interactive use in a web environment. The application shall be able to handle repeated analysis requests for the supported study area without performance degradation under normal load. The visualization of class percentages and temporal change results shall be clear and readable, with sufficient responsiveness for academic demonstration and user interpretation.

3.2.3 Software Requirements

The frontend of the system shall be developed using HyperText Markup Language (HTML) and Cascading Style Sheets (CSS). The backend shall be implemented using FastAPI, which shall handle request processing and model inference. The map interface shall be built using Leaflet, which shall support user interaction for region selection.

The analytical model shall be executed on the backend using the Python-based machine learning environment. The system shall require a modern web browser such as Google Chrome, Mozilla Firefox, or Microsoft Edge for access. Python libraries used for geospatial processing, model execution, and data handling shall be installed in the backend environment. The application shall operate in a standard development or deployment environment that supports browser-server communication.

3.2.4 Hardware Requirements

The system shall run on a standard computer system with sufficient memory and processing capability to support web application execution and model inference. A multi-core processor, at least 8 GB RAM, and a stable storage device shall be considered adequate for development and testing. For improved model execution and smoother handling of geospatial analysis, a system with 16 GB RAM or higher shall be preferred.

The backend execution environment shall have adequate CPU resources to handle model prediction and temporal analysis. A graphics processing unit shall not be mandatory for basic system operation, but it may be useful if deep learning-based processing is extended in future versions. A reliable internet or local network connection shall be available for browser access and frontend-backend communication.

3.2.5 Design Constraints

The major design constraint of the system was its Bangalore-only applicability. Since the model had been trained only on Bangalore data, the system could not be generalized confidently to other regions without retraining or recalibration. This constraint was deliberately imposed to maintain prediction validity and consistency.

Another constraint was the use of a simple Linear Regression approach for future prediction. This limited the forecasting capability to trend-based estimation rather than advanced temporal modeling. The architecture also depended on a separate frontend and backend, which required proper API coordination and stable request-response handling. In addition, the system design had to support interactive map selection while keeping the interface simple enough for academic use and demonstration purposes.

The current scope also excluded the RAG-based chatbot feature, since that component was still under development and planned for later integration. Because of this, the present design remained focused on map analysis, change analysis, and prediction only. This kept the system aligned with the completed implementation and avoided introducing incomplete functionality into the requirement specification.

3.3 Summary

EcoChangeNet was developed as a web-based geo-ecosystem analysis system for Bangalore Urban, with a browser frontend, FastAPI backend, and Leaflet-based map interaction. The product was designed to support land-cover classification, multi-temporal change analysis, and simple trend-based future prediction within a controlled geographic scope. Its architecture separated user interaction from backend model execution, which made the system modular, easier to use, and suitable for academic deployment.

The specific requirements showed that the system had clear functional goals, acceptable performance expectations, standard software and hardware needs, and well-defined design constraints. The main limitation was that the model was trained only on Bangalore data, so the application was intentionally restricted to that region. Overall, the system provided a practical framework for spatial analysis and environmental monitoring through a web-based interface.

CHAPTER 4

High Level Design

4.1 Design Considerations

The design of EcoChangeNet was guided by the need to develop a web-based geo-ecosystem analysis system that was practical, interactive, and academically sound. Since the project combined map-based region selection, backend model execution, land-cover classification, change analysis, and future trend prediction, the overall design had to ensure smooth interaction between the user interface and the analytical engine. The system was therefore planned as a browser-accessible application with a clear separation between presentation and processing. This allowed the application to remain simple for the user while still supporting complex spatial analysis in the background.

4.1.1 General Considerations

Several general considerations influenced the design of the system. The first was usability. The application was intended for users who may not be familiar with remote sensing tools or machine learning workflows, so the interface had to be easy to understand and operate. For this reason, the homepage was kept clean and direct, with clearly visible options for map analysis and change analysis. The use of an interactive map made the workflow more natural because users could visually select the region rather than entering technical spatial coordinates.

The second consideration was domain specificity. The model had been trained only on Bangalore data, so the system needed to remain limited to Bangalore Urban for valid analysis. This constraint was essential because a model trained on one geographic region may not produce reliable outputs for another region with different land-cover patterns, urban structure, and environmental characteristics. Therefore, the design deliberately restricted the operational scope to preserve accuracy and consistency. This geographic limitation was not a weakness in the system but a necessary design decision to maintain scientific validity.

The third consideration was modularity. The application contained several distinct functional components, including region selection, land-cover estimation, multi-temporal change analysis, and future prediction. These functions were arranged as separate logical modules so that each part could operate independently while still contributing to the overall system. Modularity improved readability of the codebase, simplified testing, and made it easier to introduce future changes. It also helped maintain a clean separation between the frontend pages and the backend analytical workflow.

Another important consideration was performance. Since the system was designed for web use, the analysis results had to be returned quickly enough to support interactive exploration. A slow application would reduce user confidence and make the interface inconvenient for demonstration. The architecture therefore emphasized efficient request handling through the backend and a lightweight frontend design that could display results without unnecessary delay. This was especially important for spatial and temporal analysis, where processing time can increase if the workflow is not structured carefully.

The design also considered clarity of output presentation. Geospatial analysis results can become difficult to interpret if they are shown without structure or visual hierarchy. To address this, the application was designed to present class-wise land-cover percentages, change trends, and future predictions in a clear and segmented manner. This helped the user understand not just the computed output, but also its meaning in the context of land-cover monitoring. The system was therefore designed as both an analytical tool and a visual interpretation platform.

A further consideration was maintainability and extensibility. The frontend was developed using HTML and CSS, while the backend was implemented using FastAPI, which made the system easier to organize and update. This separation allowed changes in the interface and changes in the model-processing logic to be handled independently. It also created room for future improvements, such as expanding the analysis modules or integrating additional intelligent features later. The design was therefore not only focused on the present implementation but also on possible future growth.

4.1.2 Development Methods

The development of EcoChangeNet followed a structured and iterative method. The system was not built in a single stage; instead, it was developed step by step so that each module could be tested and validated before moving to the next. First, the overall interface structure was created using HTML and CSS. Then the interactive mapping component was added using Leaflet. After that, the backend was connected using FastAPI so that the frontend could communicate with the analytical layer. This staged approach reduced integration problems and made the development process more manageable.

The next development method was analysis-first construction. Before finalizing the web interface, the analytical workflow was defined so that the application would reflect the real capabilities of the trained model. The land-cover classification logic, change detection strategy, and trend prediction method were established first, and then the interface was designed around these functions. This ensured that the final product was not just visually appealing, but also functionally aligned with the underlying model.

The system also followed a modular development approach. Each major function was handled as a separate unit: the homepage for navigation, the map analysis module for class distribution, the change analysis module for temporal comparison, and the prediction module for future trend estimation. By dividing the application into smaller parts, the development process became easier to control and debug. If a problem occurred in one module, it could be identified without affecting the entire system. This modular workflow is especially useful in projects that combine web development with machine learning and geospatial analysis.

Another important method used in the development was incremental integration. Rather than building the full system and testing it only at the end, individual components were connected gradually and reviewed as they were completed. The frontend pages were first checked for layout and usability, then the map selection was tested, and finally the backend model connection was verified. This incremental method helped ensure that the system remained functional throughout development and reduced the risk of major failures near completion.

The development process also reflected a prototype-oriented approach. Since the project was academic in nature, the goal was to build a working system that demonstrated the concept clearly rather than to create a large-scale production platform. The design choices therefore focused on demonstrating land-cover monitoring, change analysis, and prediction in a practical web environment. This allowed the project to stay within a realistic development scope while still showing technical depth.

4.2 Architecture Strategies

The architecture of EcoChangeNet was organized to support a browser-based workflow in which the frontend handled interaction and the backend handled analysis. This strategy kept the system lightweight for the user while allowing the trained model to remain on the server side. The overall structure was chosen so that map selection, model execution, and result display could work as connected stages within one application. Since the project was trained on Bangalore data, the architecture was also intentionally limited to that geographic scope.

4.2.1 Programming Language

The programming language used for the backend implementation was Python. It was selected because the project required integration of backend web services, model execution, and result processing in a single environment. Python also supported the analytical workflow needed for the project, especially where the trained model had to run on the backend and return outputs to the web interface. The frontend was developed separately using HTML and CSS, while the backend communication was handled through FastAPI.

Python was suitable for this project because it allowed the backend to remain flexible and easy to connect with the frontend. It also supported the logic required for land-cover analysis, change detection, and trend-based prediction. Since the system was built as an academic project rather than a general-purpose software product, Python offered a practical and efficient development environment for the overall architecture.

4.2.2 Future Plans

The system was planned to be extended in future work with a Retrieval-Augmented Generation-based chatbot. This feature was not part of the current completed implementation, so it was not included in the present analysis sections. The planned chatbot would later provide a more interactive way for users to query and understand the results of the geo-ecosystem analysis.

Future enhancement was also expected in the direction of improving the analytical depth of the application. At present, the system focused on map analysis, change analysis, and linear trend-based prediction. Later development could expand the range of interaction and interpretation functions while keeping the same web-based structure. The current architecture was therefore designed in a way that could support further enhancement without changing the complete system foundation.

4.3 System Architecture

EcoChangeNet was designed using a client-server architecture in which the user interacted with the application through a web browser, while the analytical processing was performed on the backend. This architecture was appropriate because the system required both an interactive map interface and server-side model execution. The overall structure separated presentation, processing, and result delivery into distinct layers, which improved maintainability and made the system easier to extend in future work.

At the client side, the frontend was developed using HTML and CSS. This layer was responsible for displaying the homepage, navigation options, map interface, and analysis pages. The user accessed the system through these pages and selected the required analysis module. The frontend also integrated the Leaflet map, which allowed the user to choose the study region visually instead of relying on manual coordinate input. Since the application was trained only on Bangalore data, the interactive map operated within that intended geographic scope.

The application layer was implemented using FastAPI. This layer received the user request from the frontend, processed the selected input, and triggered the backend model pipeline. After processing, the backend returned the computed outputs to the frontend for visualization. This layer formed the core communication bridge between the browser interface and the trained analytical model. Keeping the model on the server side made the system more controlled and avoided exposing the model directly to the user.

The analytical layer consisted of the trained model and the supporting computation logic used for map analysis, change analysis, and linear trend prediction. The model generated land-cover class outputs and class-wise percentages for the selected region. It also supported multi-temporal comparison so that changes across different years could be measured and interpreted. For the future prediction module, the system used a simple Linear Regression-based approach to estimate trend direction from the available temporal outputs.

The architecture can be represented in simplified form as follows:

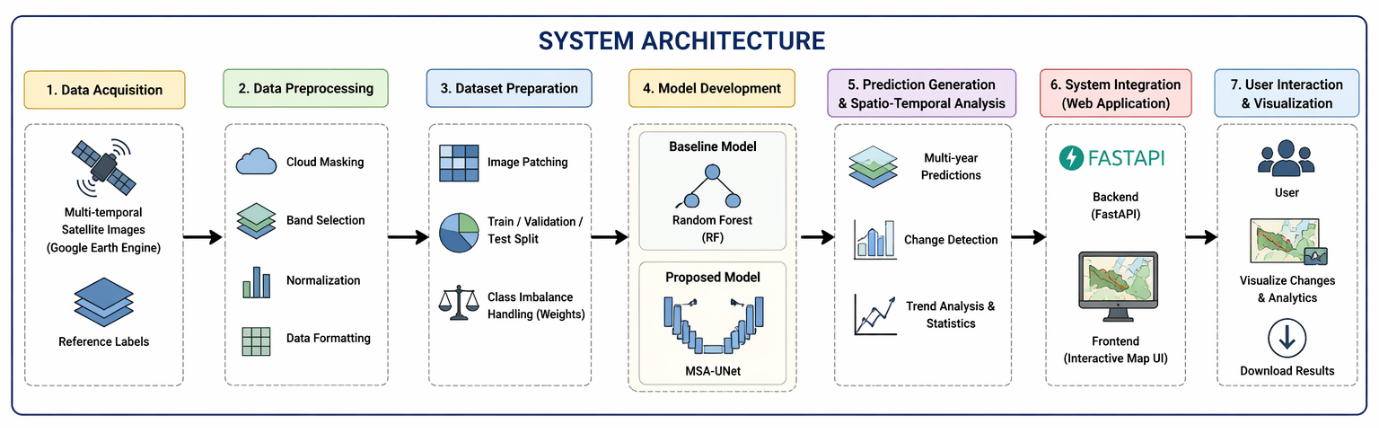
[picture p27: figure]

Figure 4.1 System Architecture

The data flow started when the user selected a feature on the homepage and chose a region on the map. The frontend sent this request to the FastAPI backend, which invoked the trained model and computed the required outputs. The results were then returned to the frontend and displayed as land-cover percentages, change analysis outputs, or trend-based future predictions. This flow kept the system easy to understand and suitable for academic presentation because the movement of data followed a clear sequence from input to processing to output.

The architecture was also designed with future extension in mind. Even though the current working system focused on map analysis, change analysis, and prediction, the same layered structure could support additional modules later without changing the whole application. The current separation between frontend and backend therefore provided both stability and flexibility. This made the system suitable for incremental enhancement while preserving the existing trained-model workflow.
