darshacharya/KANDA/overleaf/images/architecture.png

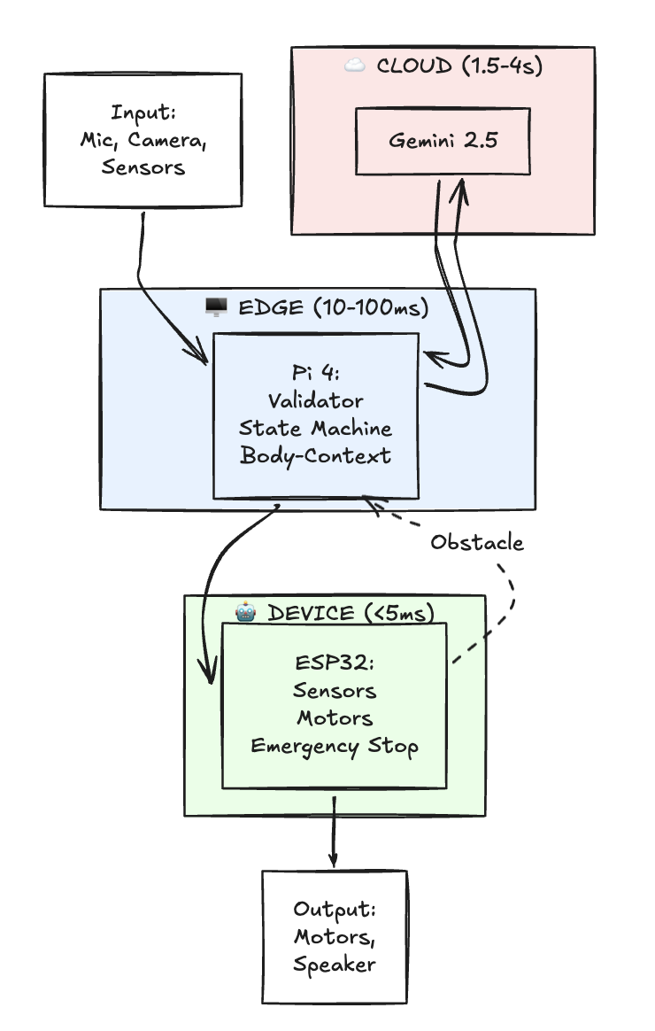
overleaf/images/architecture.png
