darshacharya/KANDA/overleaf/images/ch1_phases_roadmap.png

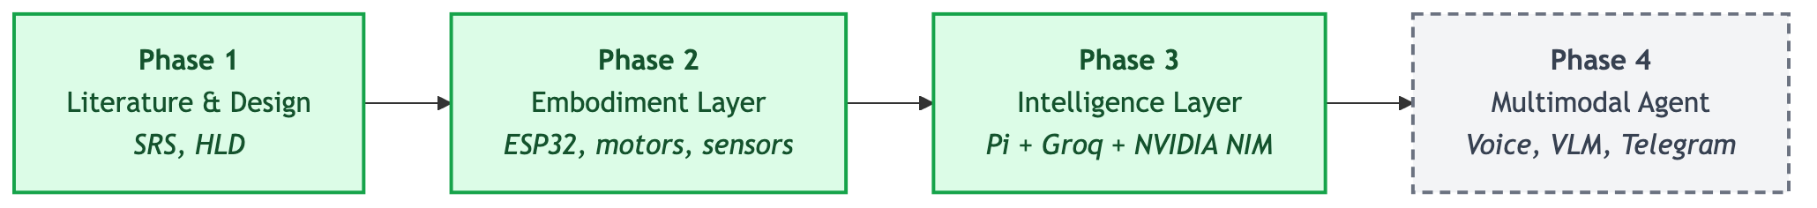
overleaf/images/ch1_phases_roadmap.png
