darshacharya/KANDA/overleaf/images/dataflow.png

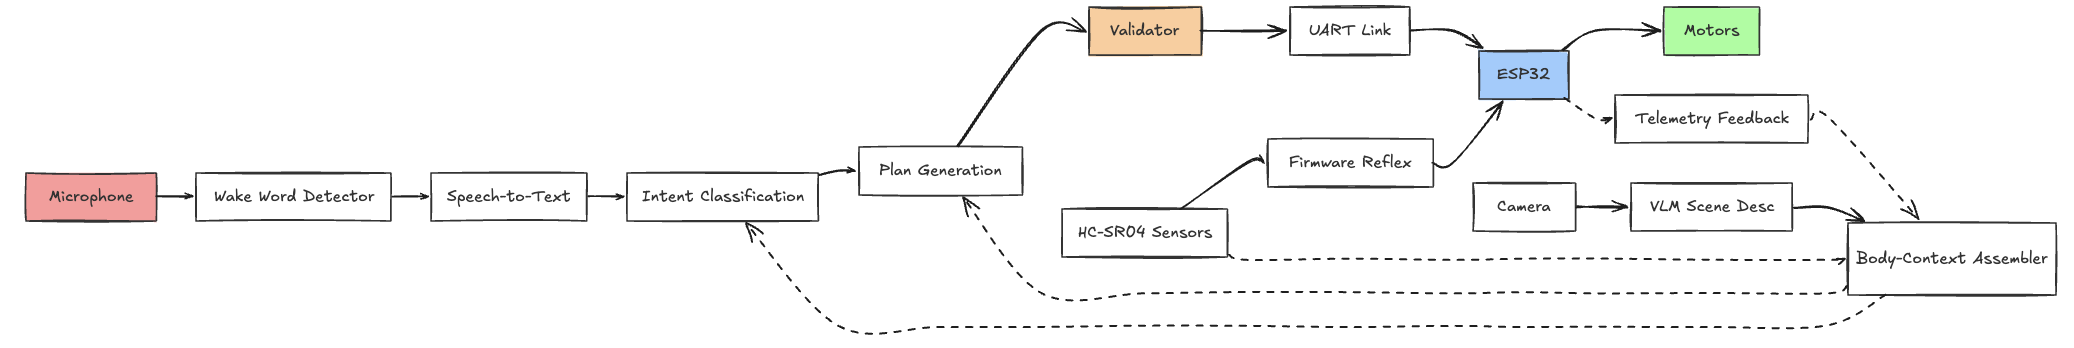
overleaf/images/dataflow.png
