darshacharya/KANDA/website/imgs/WhatsApp Image 2026-05-31 at 12.09.45 PM (1).jpeg

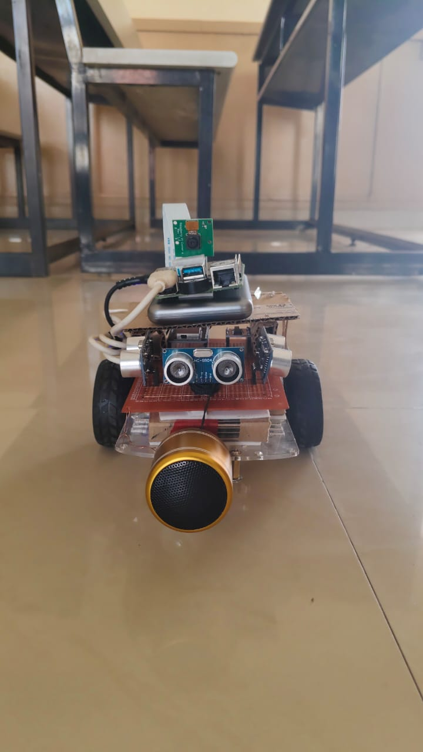
website/imgs/WhatsApp Image 2026-05-31 at 12.09.45 PM (1).jpeg
