darshacharya/KANDA/website/imgs/WhatsApp Image 2026-05-31 at 12.09.45 PM.jpeg

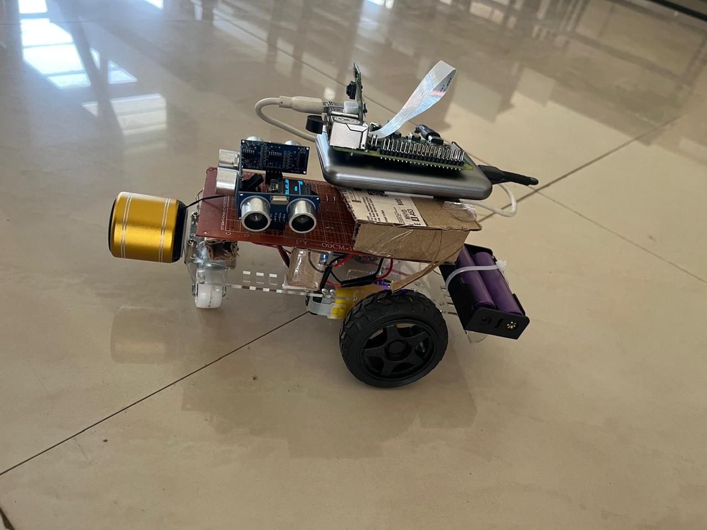
website/imgs/WhatsApp Image 2026-05-31 at 12.09.45 PM.jpeg
