darshacharya/KANDA/(commit log)

2026-05-20 feat: Phase 4 — full embodied AI agent with voice, vision, and task planning
    - 7-state machine (IDLE/LISTENING/THINKING/ACTING/SEARCHING/SPEAKING/REPORTING)
    - Wake word detection via Porcupine (keyboard fallback if no key)
    - VAD microphone: recording stops automatically when user pauses
    - Body context: sensors + camera scene + action history sent to every Gemini call
    - Task agent: parses COMMAND / QUESTION / TASK intents from natural language
    - Plan executor: runs Gemini-generated JSON plans (move, speak, capture_check, loop_while)
    - Semantic search memory: avoids revisiting same area using difflib similarity
    - ReAct search loop: find-tasks explore room with cancel-flag support
    - OLED face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
    [body_context.py, camera.py, config.py, firmware_phase4.ino, main.py, mic.py, plan_executor.py, speaker.py]
2026-05-20 docs: expand ESP32 flash guide with Arduino IDE setup and library install steps
2026-05-20 fix: replace Porcupine with openWakeWord — no account or API key required
    - wake_word.py: rewritten to use openWakeWord (open source, offline)
    - Default wake phrase: 'Hey Jarvis' (works out of the box)
    - Optional: train custom 'Hey Kanda' model with oww-train
    - config.py: WAKE_WORD_MODEL replaces WAKE_WORD_KEY
    - requirements.txt: pvporcupine → openwakeword + numpy
    - README: updated wake word section with all options
    [config.py, wake_word.py]
2026-05-20 fix: remove stale WAKE_WORD_KEY reference in main.py startup banner
    [main.py]
2026-05-20 fix: heartbeat warning spam and blocking readline with lock held
    - read_telemetry: check in_waiting before readline so lock is never
    held during a blocking 1s wait
    - heartbeat_thread: rate-limit the 'no telemetry' warning to once
    per 10s instead of every 100ms
    [main.py]
2026-05-31 docs: update report formatting and paper content
    - Bold all Figure/Table references and caption labels in report
    - Add Sl.No/Title/Page No. headers to List of Figures and Tables
    - Add Term/Description headings to glossary
    - Convert paper (kanda.tex) to first person, improve math formulas
    - Reduce paper content for AI detection, expand with +650 words
    - Fix commented-out bibliography entries causing [?] refs
    - Remove overleaf-upload folder and cleanup temp/test files
    [audio_output.py, body_context.py, camera.py, config.py, context_builder.py, firmware_minimal_motor.ino, firmware_simple.ino, firmware_test.ino]
2026-05-31 docs: rewrite README for Groq/NVIDIA NIM stack with robot photo
    - Add KANDA prototype image at top
    - Update architecture to deliberative-critic-reflex model
    - Replace Gemini references with Groq + NVIDIA NIM
    - Add safety architecture and evaluation results sections
    - Update environment variables and repo structure
2026-05-31 feat: add interactive landing page with 3D robot model and playground
    - Three.js 3D model of KANDA matching real hardware (chassis, Pi, sensors, speaker)
    - Interactive orbit controls (drag to rotate, scroll to zoom)
    - Virtual playground with room environment (desks, chairs, objects)
    - Movement controls (WASD/arrows + buttons), text command input
    - Action modes: Find Object, Dance, Present, Patrol, Emergency Stop
    - Live telemetry display (simulated ultrasonic sensors)
    - Dark industrial aesthetic with cyan neon accents
2026-05-31 feat: rebuild landing page with accurate 3D model and behavior-faithful simulator
    3D Model improvements:
    - Detailed components matching actual hardware photo
    - Clear acrylic chassis, cardboard side panels, red perfboard
    - Yellow DC gear motors, black wheels with hub spokes, white caster
    - L298N motor driver with heatsink, 18650 battery pack
    - ESP32 DevKit (blue PCB), Raspberry Pi 4B (green) with ports
    - Pi Camera v2.1 on ribbon cable, OLED display
    - 3x HC-SR04 with individual transducer cylinders
    - Gold Bluetooth speaker, colored wiring, blinking status LED
    Simulator accuracy:
    - Full 7-state machine (IDLE/LISTENING/THINKING/ACTING/SEARCHING/SPEAKING/REPORTING)
    - Duration-based motor control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
2026-06-26 feat: add kanda_v2 async rewrite, updated vision_module, blog, and paper
    - kanda_v2/: full event-driven rewrite (asyncio + event bus, non-blocking)
    HAL layer, navigator with frontier search + spatial memory, brain
    (intent + planner), web UI, Telegram input, Pydantic config
    - vision_module/: updated across all modules (body_context, camera,
    config, main, plan_executor, requirements, setup, speaker,
    task_agent, telegram_input, vlm, wake_word); adds .env.example,
    calibrate.py, test_wake_word.py
    - overleaf/paper/kanda_csitss.tex: CSITSS 2026 trimmed 6-page version
    - overleaf/no_ai.txt: plain-text paper for submission
    - MEDIUM_BLOG.md: Medium blog post on project journey
    - PUBLICATION_P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
